bcarrillo1051/Atinverter/README.md

# Atinverter
Open Source DC to AC Inverter Documentation: https://bcarrillo1051.github.io/Atinverter/
