bcarrillo1051/Atinverter/sims/Boost Converter/ExportFiles/README.txt

## WEBENCH Design 4
Created at Sat Feb 22 22:12:48 CST 2025
**********************************************************
*******************  SIMULATION Instructions  ************
**********************************************************

This TINA Schematic can be opened in TINA-TI and simulated using TINA-TI. 

TINA-TI provides all the conventional DC, transient and frequency domain 
analysis of SPICE and much more. TINA has extensive post-processing capability 
that allows you to format results the way you want them. Virtual instruments 
allow you to select input waveforms and probe circuit nodes voltages and waveforms. 
TINA's schematic capture is truly intuitive - a real "quickstart."

TINA-TI installation requires approximately 500MB. Installation is straight-forward
 and it can be uninstalled easily, if you wish. We bet that you won't.

TINA is a product of DesignSoft exclusively for Texas Instruments. 
This complimentary version is fully functional but does not support some other 
features available with the full version of TINA.

For a complete list of available TINA-TI models, see: SpiceRack -- A Complete List

https://webench.ti.com/webench5/spicemodels/?DCMP=hpa_hpa_elabs&HQS=spicerack#search=tina

Download TINA-TI:
http://www.ti.com/tool/TINA-TI

Installation guide:
https://training.ti.com/tina-ti-video-training-series

More about WEBENCH simulation export to TINA-TI:
http://www.ti.com/design-tools/webench-power-design/tina-export.html
