bcarrillo1051/Atinverter/docs/hardware/atinverter_v2/inter_board_comms.md

---
title: Inter-Board Communication
layout: default
parent: Atinverter V2 Hardware
nav_order: 2
mathjax: true
---

# **I2C Inter-Board Communication Hardware**
---

- **Will be documented once I2C bus is verified**
