bcarrillo1051/Atinverter/docs/index.md

---
title: Home
layout: default

nav_order: 1
---

# **Atinverter Documentation**
### Explore the documentation to learn more about this open source power inverter!

<html>
<head>
  <style>
    .all_images {
      text-align: center; /* Center the entire section */
    }

    /* Style for each image and button container */
    .image_button_container {
      display: inline-block; /* Make each container inline */
      text-align: center; /* Center content within each container */
      margin: 21px; /* Add spacing between containers */
    }

    /* Style for images */
    .image_button_container img {
      width: 200px;
      height: 200px;
    }
  </style>
</head>
<body>
  <div class="all_images">
    <!-- Vision Image and Button -->
    <div class="image_button_container">
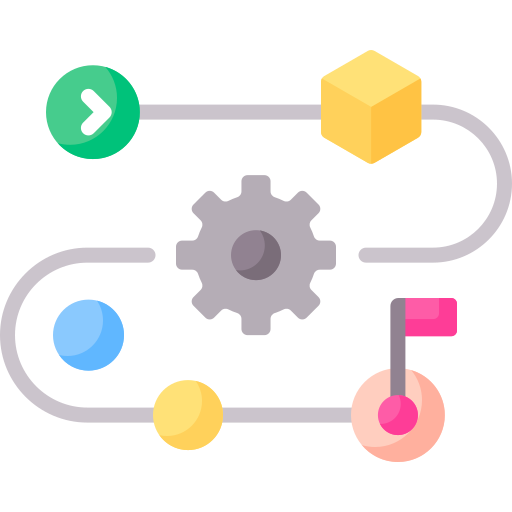
[picture p29: docs/images/vision.png]
Vision Icon
      
      <br>
      <span class="fs-6">
      <a href="vision" class="btn btn-purple">Vision</a>
      </span>
    </div>
    <!-- Hardware Image and Button -->
    <div class="image_button_container">
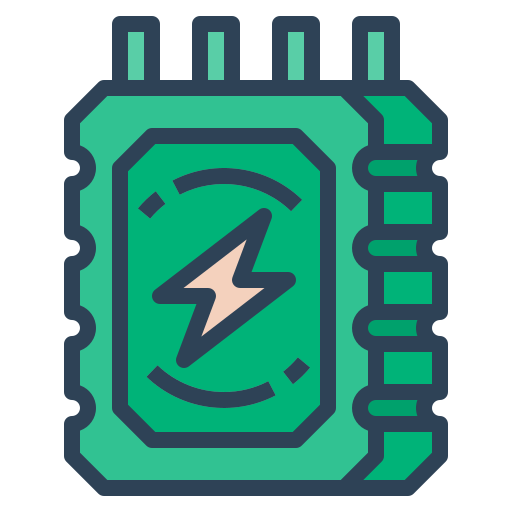
[picture p30: docs/images/hardware.png]
Hardware Icon
      
      <br>
      <span class="fs-6">
      <a href="hardware/hardware" class="btn btn-blue">Hardware</a>
      </span>
    </div>
    <!-- Software Image and Button -->
    <div class="image_button_container">
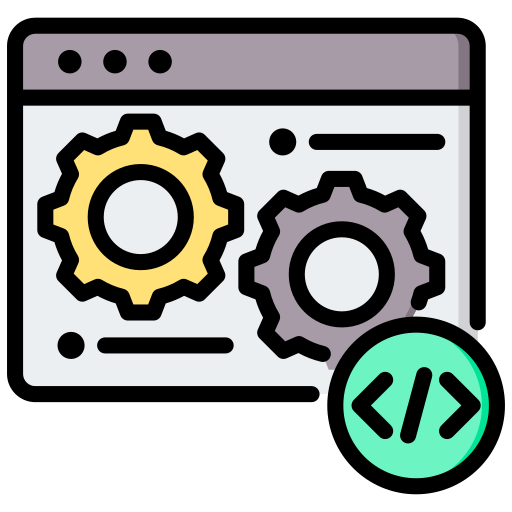
[picture p31: docs/images/software.png]
Software Icon
      
      <br>
      <span class="fs-6">
      <a href="software/software" class="btn btn-green">Software</a>
      </span>
    </div>
  </div>
</body>
</html>
