bcarrillo1051/Atinverter/docs/hardware/hardware.md

---
title: Hardware
layout: default
nav_order: 2
---

# **Hardware**
***

<html>
<head>
  <style>
    .all_images {
      text-align: center; /* Center the entire section */
    }

    /* Style for each image and button container */
    .image_button_container {
      display: inline-block; /* Make each container inline */
      text-align: center; /* Center content within each container */
      margin: 20px; /* Add spacing between containers */
    }

    /* Style for images */
    .image_button_container img {
      width: 220px;
      height: 220px;
    }
  </style>
</head>
<body>
  <div class="all_images">
    <!-- Atinverter V1 Image and Button -->
    <div class="image_button_container">
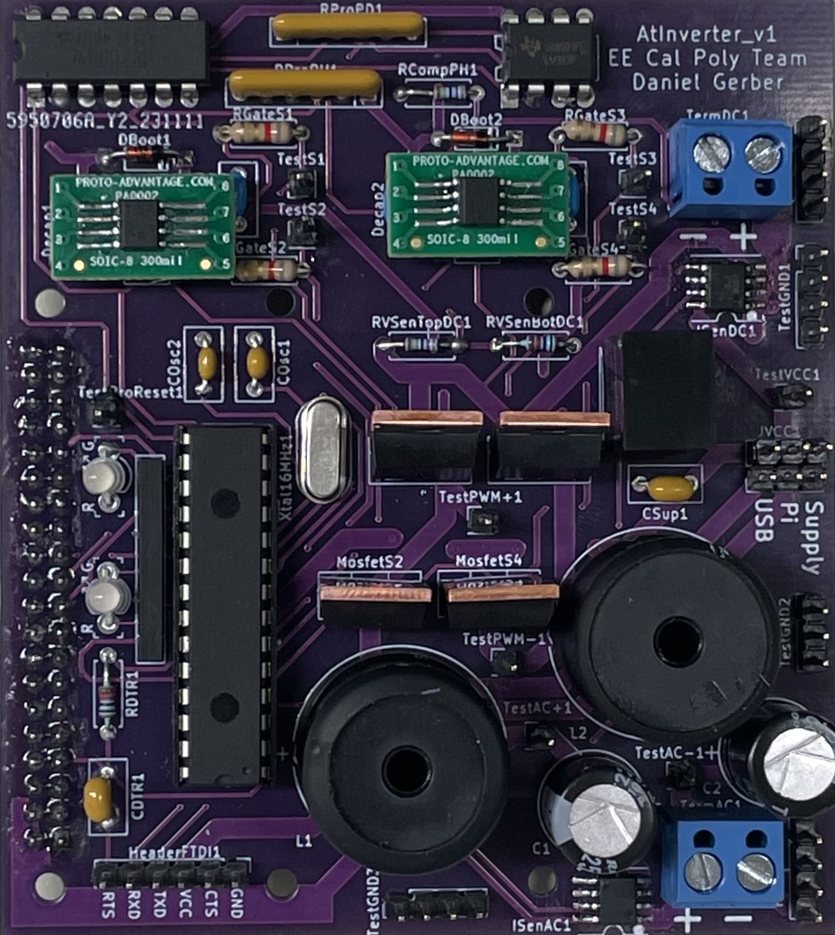
[picture p36: docs/images/a_v1_front_view.jpg]
Atinverter V1
      
      <br>
      <span class="fs-6">
      <a href="a_v1_hw" class="btn btn-purple">Atinverter V1</a>
      </span>
    </div>

    <!-- Atinverter V2 Image and Button -->
    <div class="image_button_container">
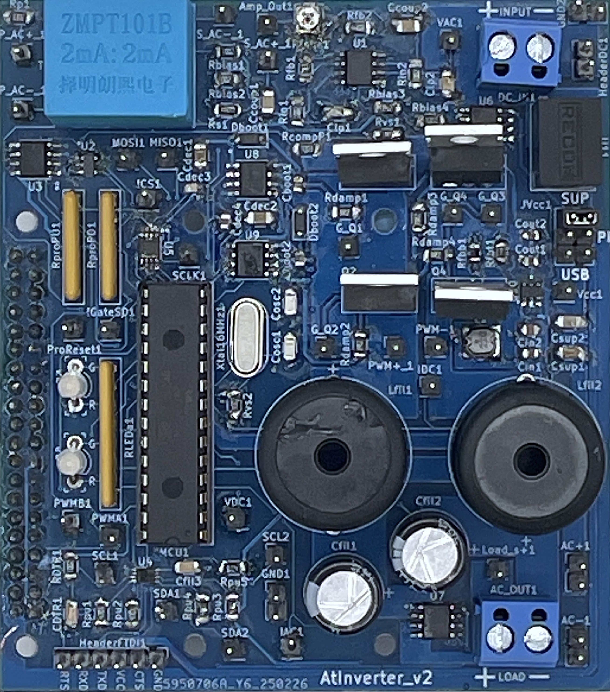
[picture p37: docs/images/AtinverterV2_top_view_raw.jpg]
Atinverter V2
      
      <br>
      <span class="fs-6">
      <a href="atinverter_v2/a_v2_hw" class="btn btn-green">Atinverter V2</a>
      </span>
    </div>
  </div>
</body>
</html>
