bcarrillo1051/Atinverter/docs/images/a_v1_sections.png

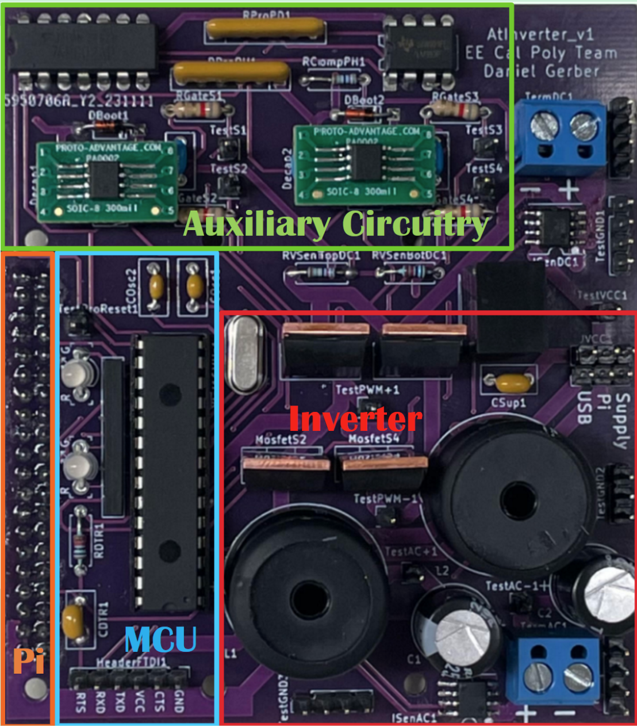
docs/images/a_v1_sections.png
