bcarrillo1051/Atinverter/docs/images/AC_voltage_sensing_circuit.png

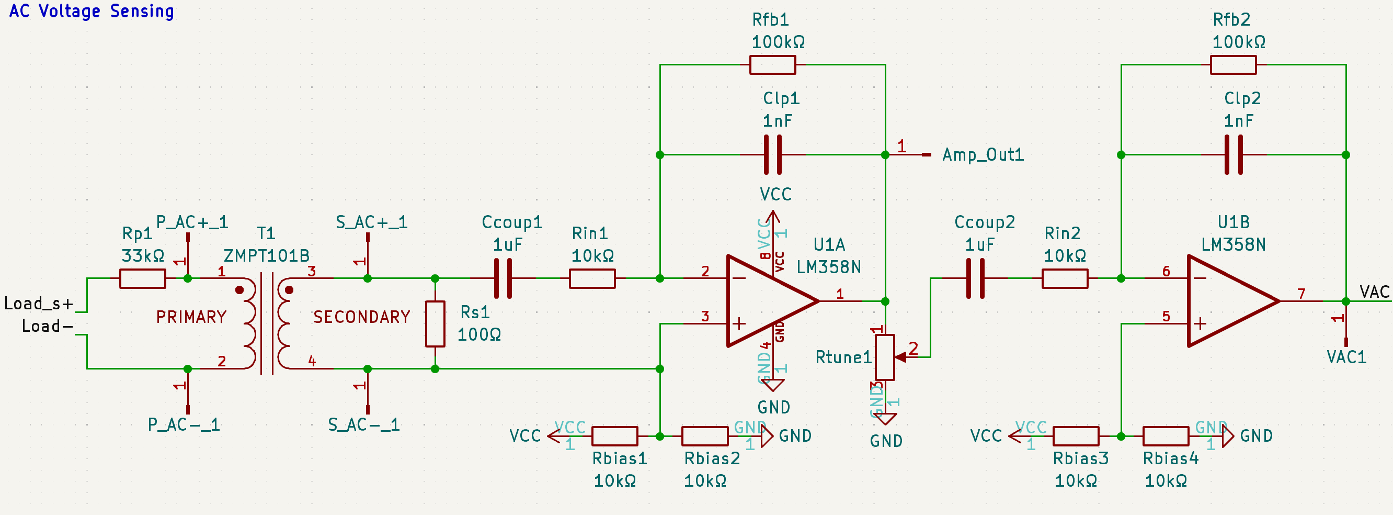
docs/images/AC_voltage_sensing_circuit.png
