bcarrillo1051/Atinverter/docs/images/AC_voltage_sensing_network_simulation_plot.png

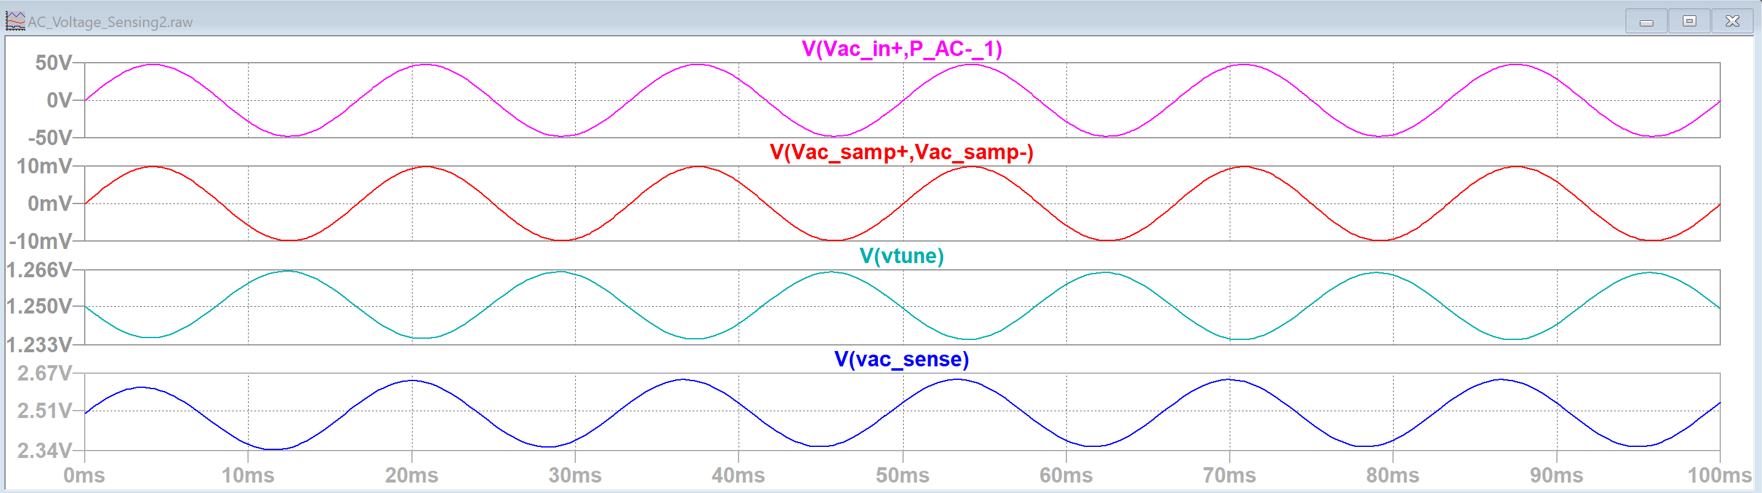
docs/images/AC_voltage_sensing_network_simulation_plot.png
