bcarrillo1051/Atinverter/docs/images/ADC_sampling_rate_sinusoid.png

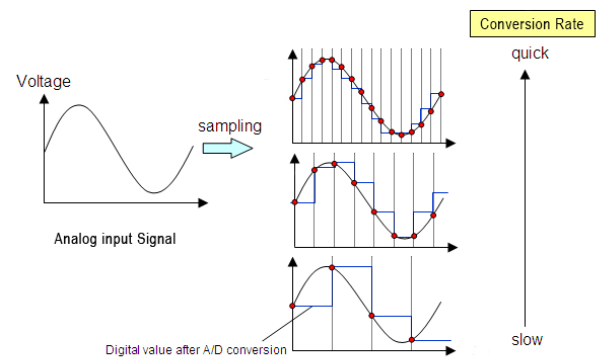
docs/images/ADC_sampling_rate_sinusoid.png
