bcarrillo1051/Atinverter/docs/images/atinverter_library_features.png

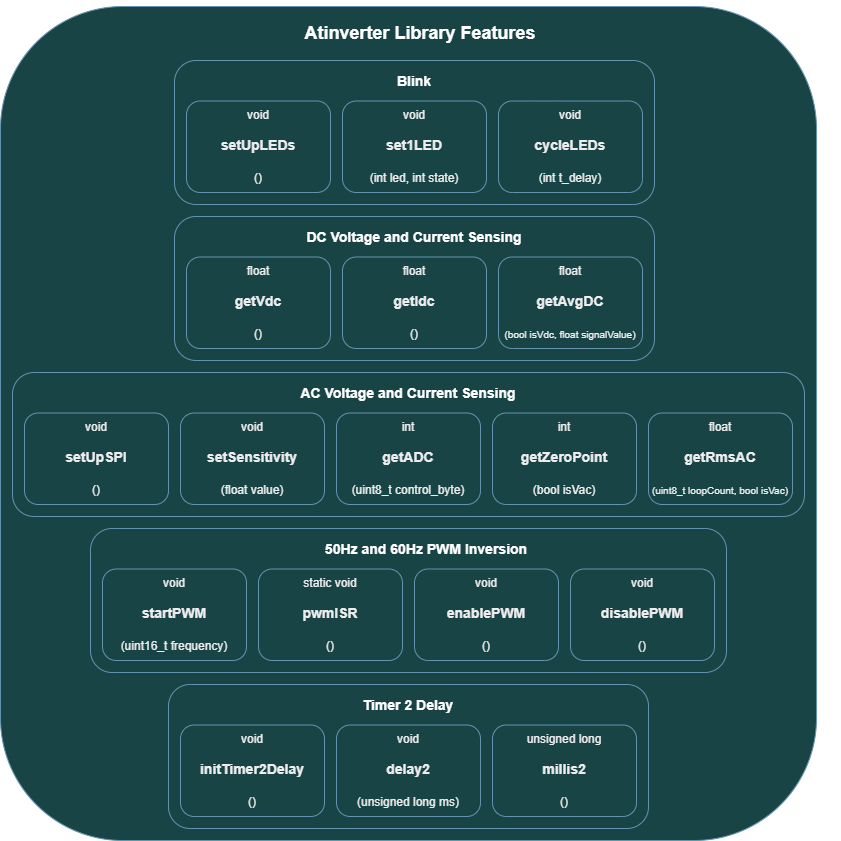
docs/images/atinverter_library_features.png
