bcarrillo1051/Atinverter/docs/images/atinverter_library_high_level.png

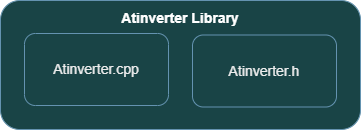
docs/images/atinverter_library_high_level.png
