bcarrillo1051/Atinverter/docs/images/atinverter_V2_software_modules_and_files.png

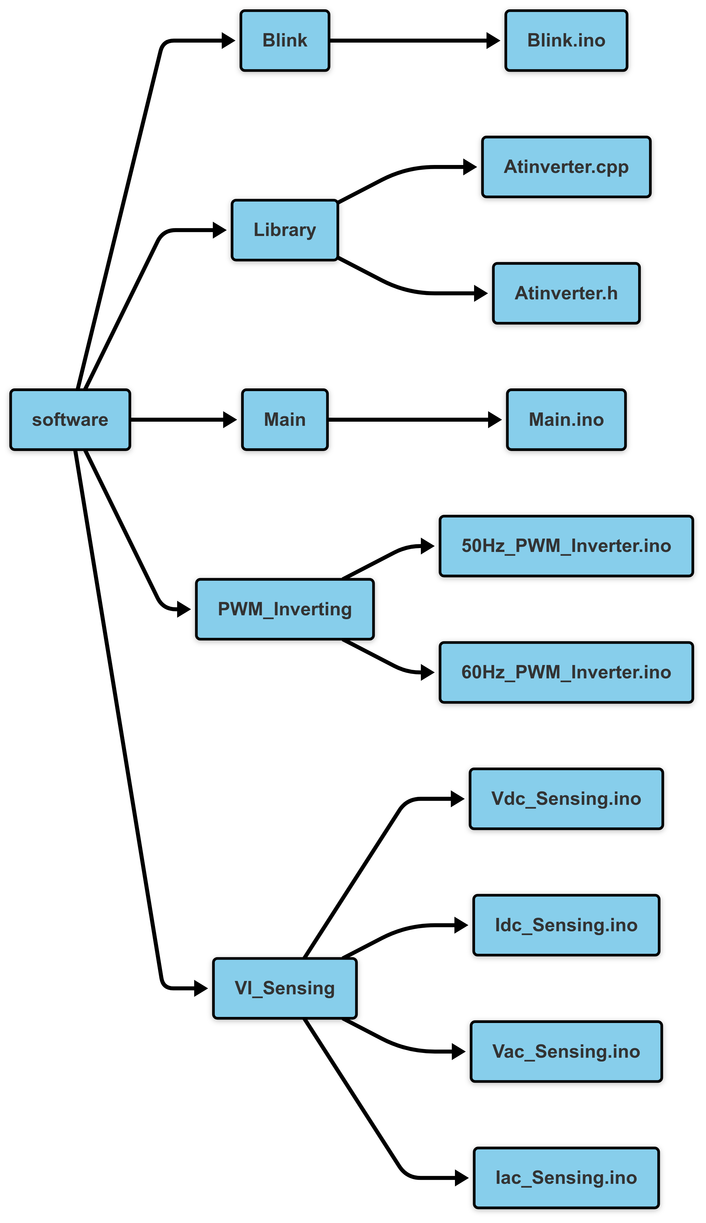
docs/images/atinverter_V2_software_modules_and_files.png
