bcarrillo1051/Atinverter/docs/images/AtinverterV2_top_view_labels.jpg

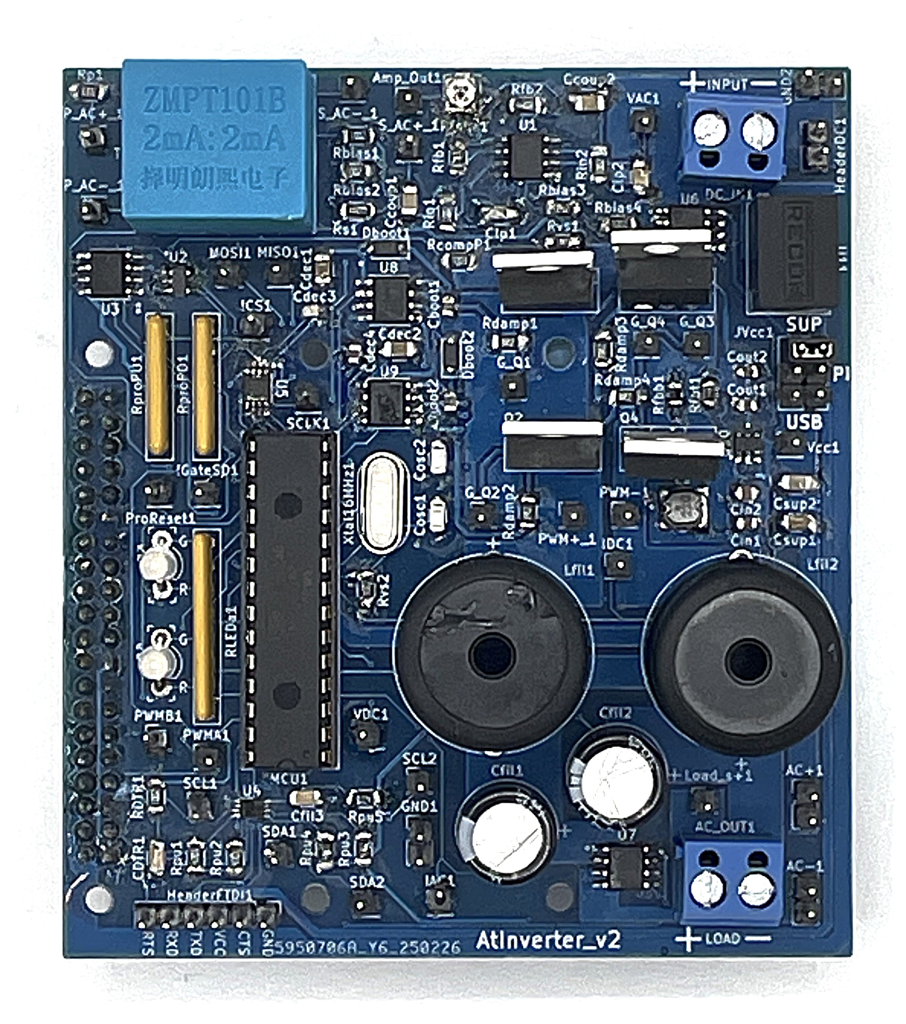
docs/images/AtinverterV2_top_view_labels.jpg
