bcarrillo1051/Atinverter/docs/images/boost_converter_duty_cycle_chart.png

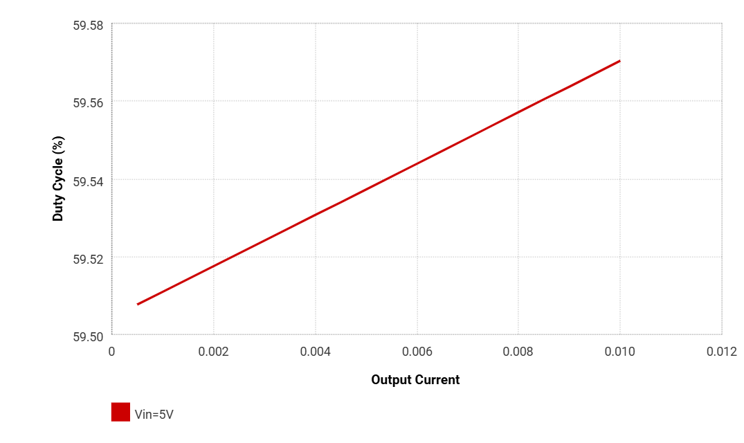
docs/images/boost_converter_duty_cycle_chart.png
