bcarrillo1051/Atinverter/docs/images/hall_effect_1.png

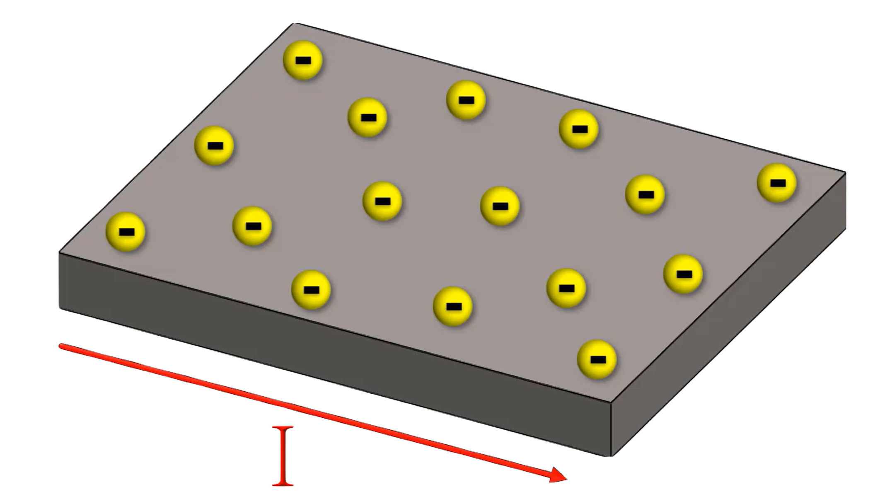
docs/images/hall_effect_1.png
