bcarrillo1051/Atinverter/docs/images/hall_effect_2.png

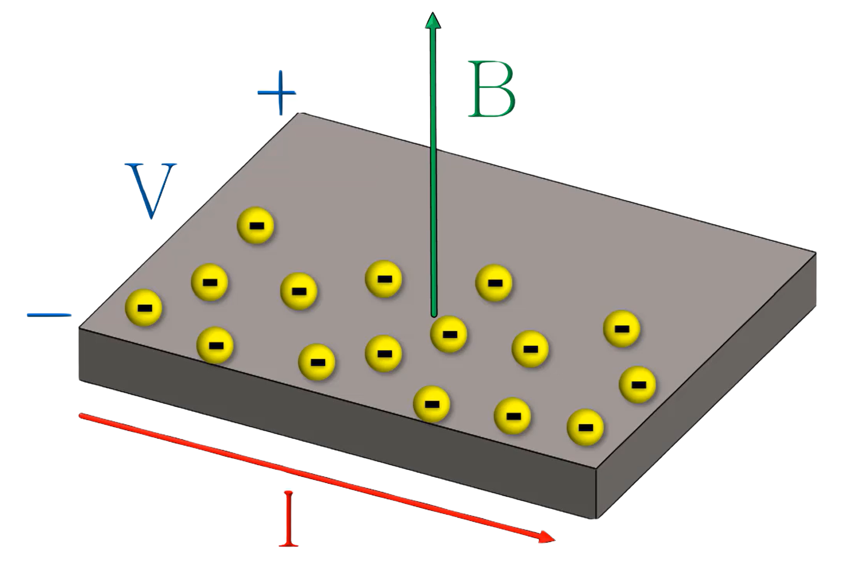
docs/images/hall_effect_2.png
