bcarrillo1051/Atinverter/docs/images/hall_effect_white_background.png

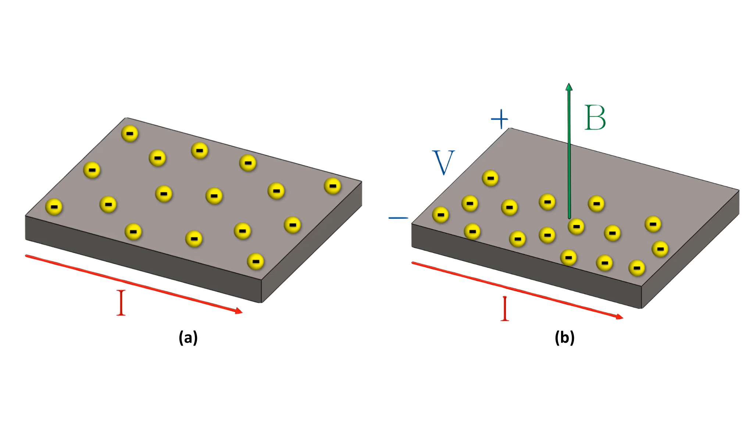
docs/images/hall_effect_white_background.png
