bcarrillo1051/Atinverter/docs/images/OVRP_circuit_white.png

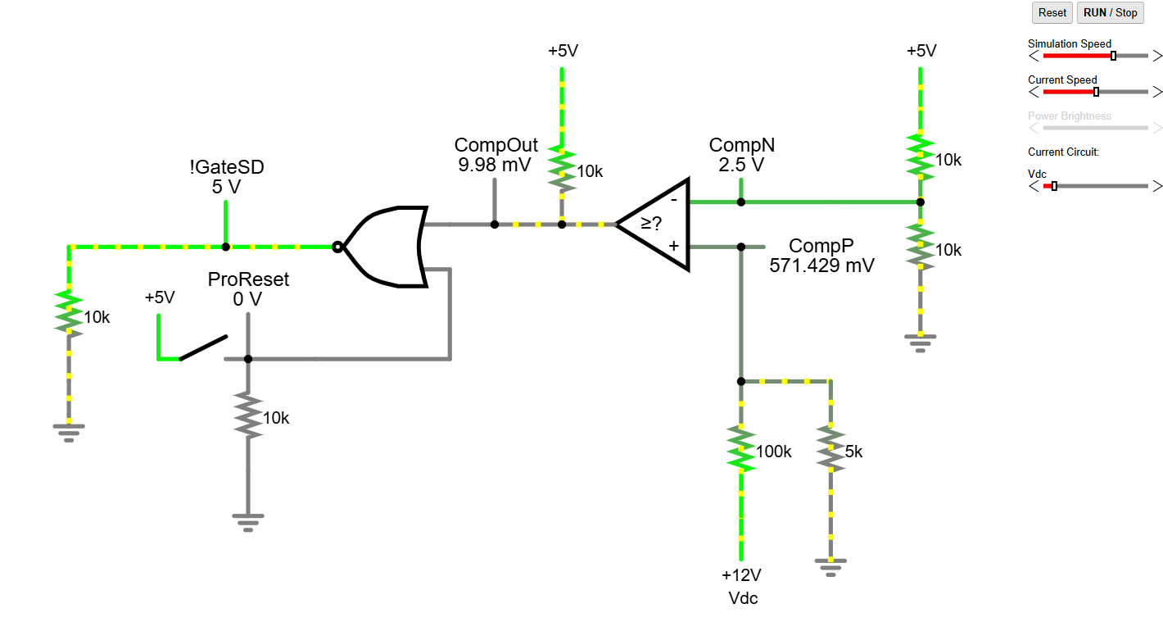
docs/images/OVRP_circuit_white.png
