bcarrillo1051/Atinverter/docs/images/software_block_diagram.png

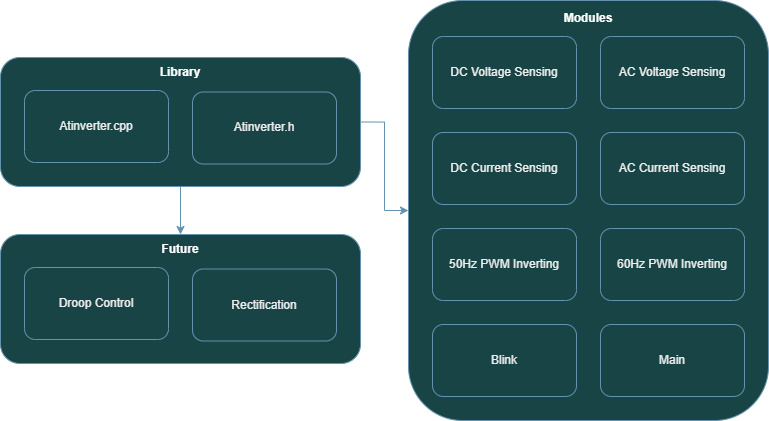
docs/images/software_block_diagram.png
