bcarrillo1051/Atinverter/docs/images/software_high_level.png

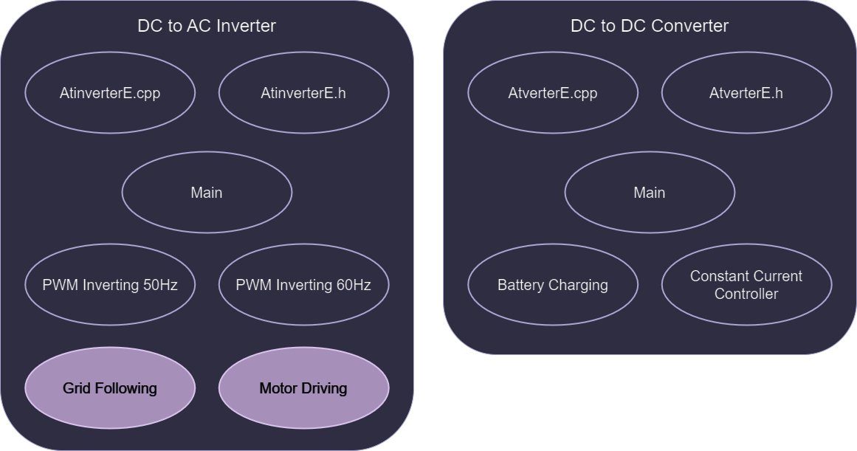
docs/images/software_high_level.png
