bcarrillo1051/Atinverter/docs/images/software_inverter.png

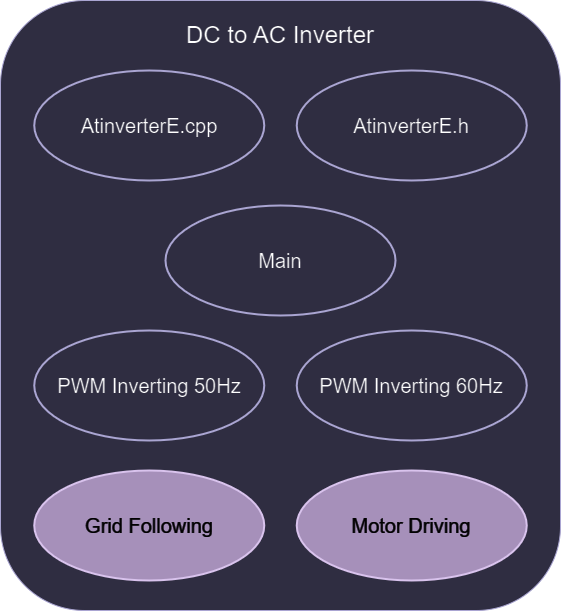
docs/images/software_inverter.png
