bcarrillo1051/Atinverter/sims/Boost Converter/12V_BOOST_CONVERTER.png

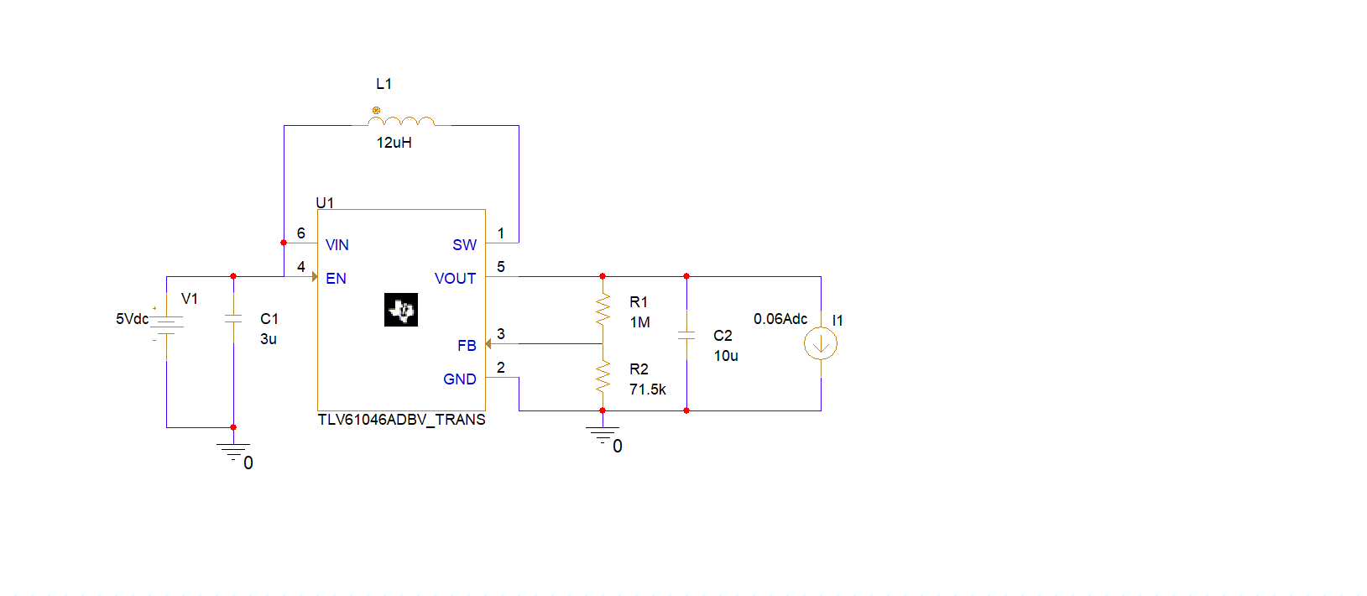
sims/Boost Converter/12V_BOOST_CONVERTER.png
