bcarrillo1051/Atinverter/docs/images/experimentation/ac_current_sensing/24.5ohms_reading.png

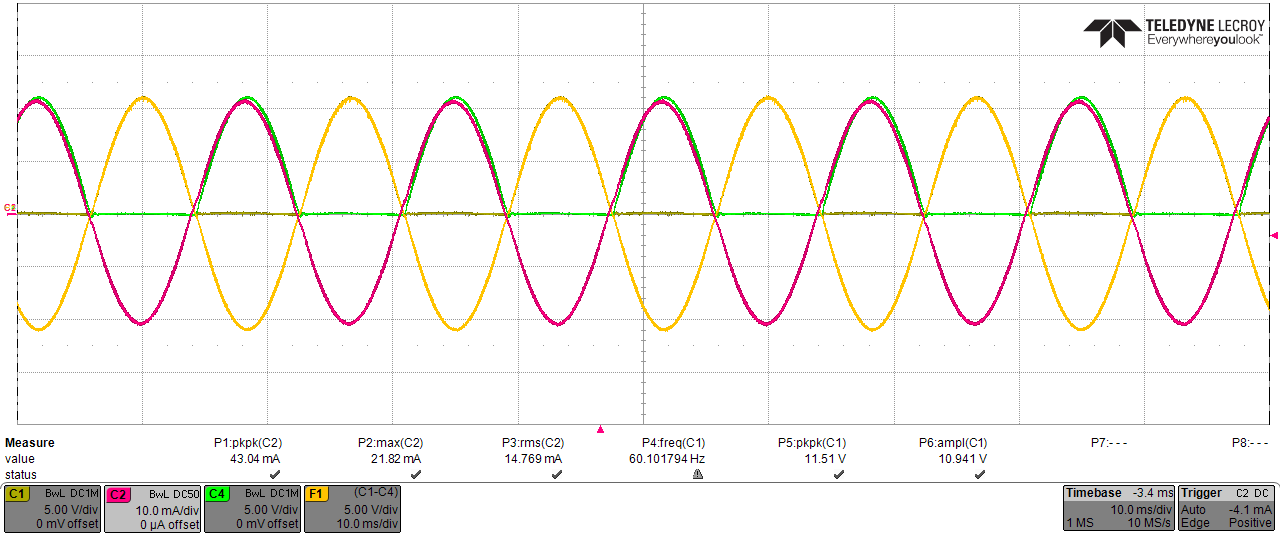
docs/images/experimentation/ac_current_sensing/24.5ohms_reading.png
