bcarrillo1051/Atinverter/docs/images/experimentation/ac_current_sensing/36. ohm_reading.png

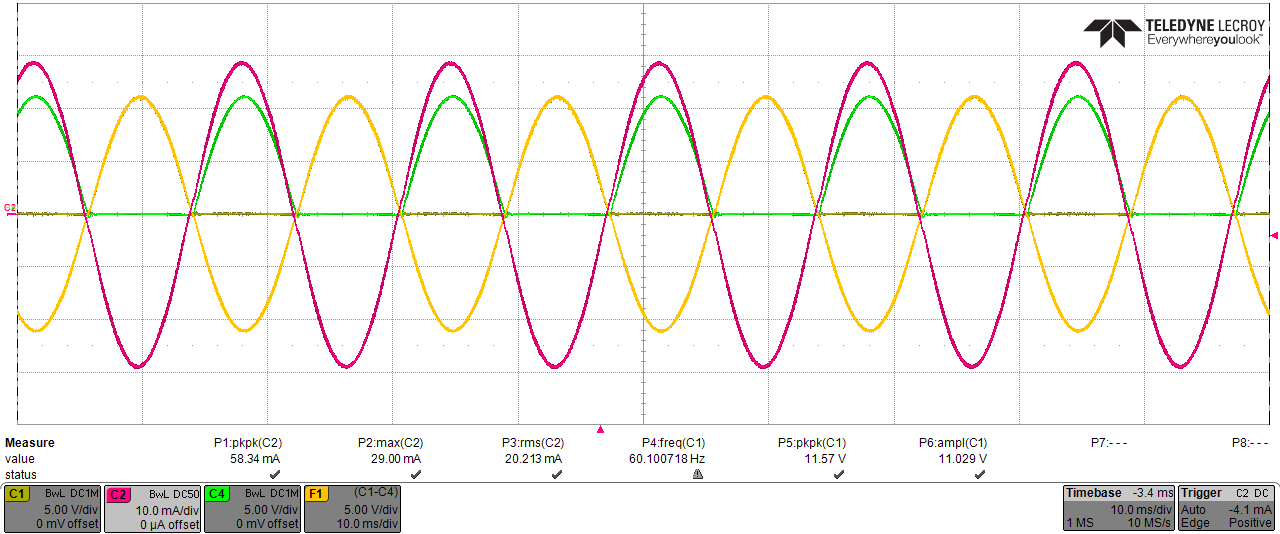
docs/images/experimentation/ac_current_sensing/36. ohm_reading.png
