bcarrillo1051/Atinverter/docs/images/experimentation/ac_current_sensing/69.6ohms_reading1.png

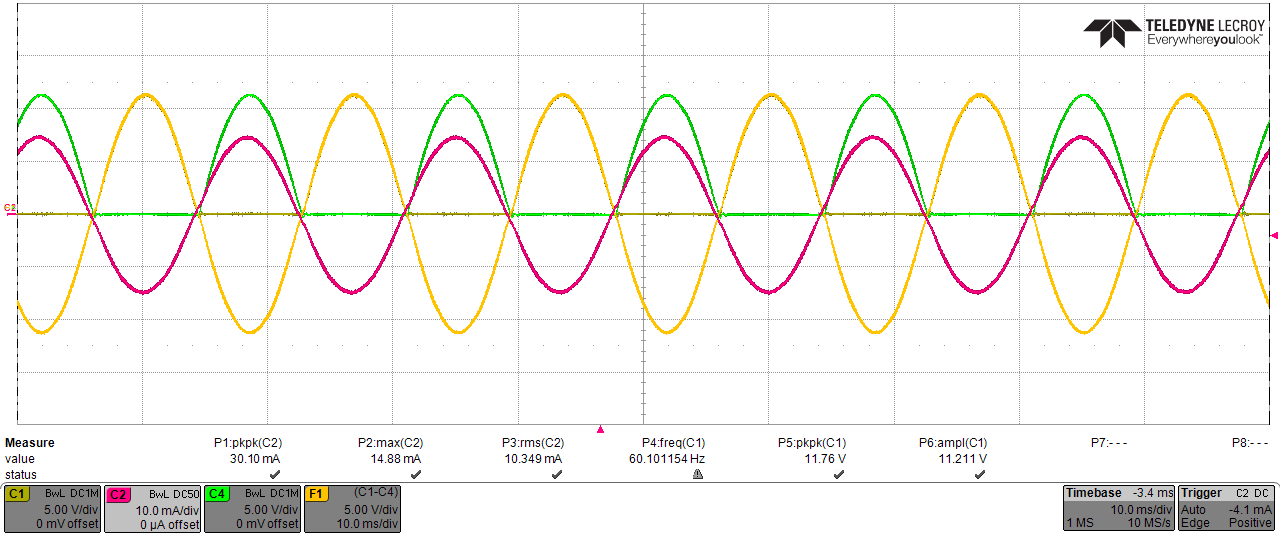
docs/images/experimentation/ac_current_sensing/69.6ohms_reading1.png
