bcarrillo1051/Atinverter/docs/images/experimentation/ac_current_sensing/4990 ohms load current reading.png

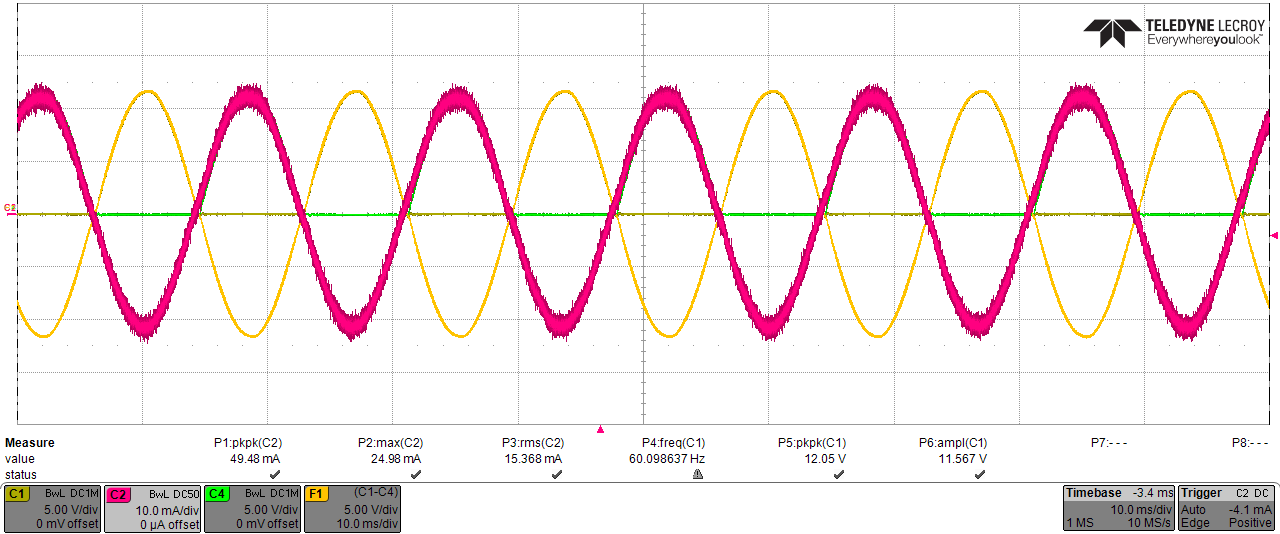
docs/images/experimentation/ac_current_sensing/4990 ohms load current reading.png
