bcarrillo1051/Atinverter/docs/images/experimentation/ac_current_sensing/current and voltqy.png

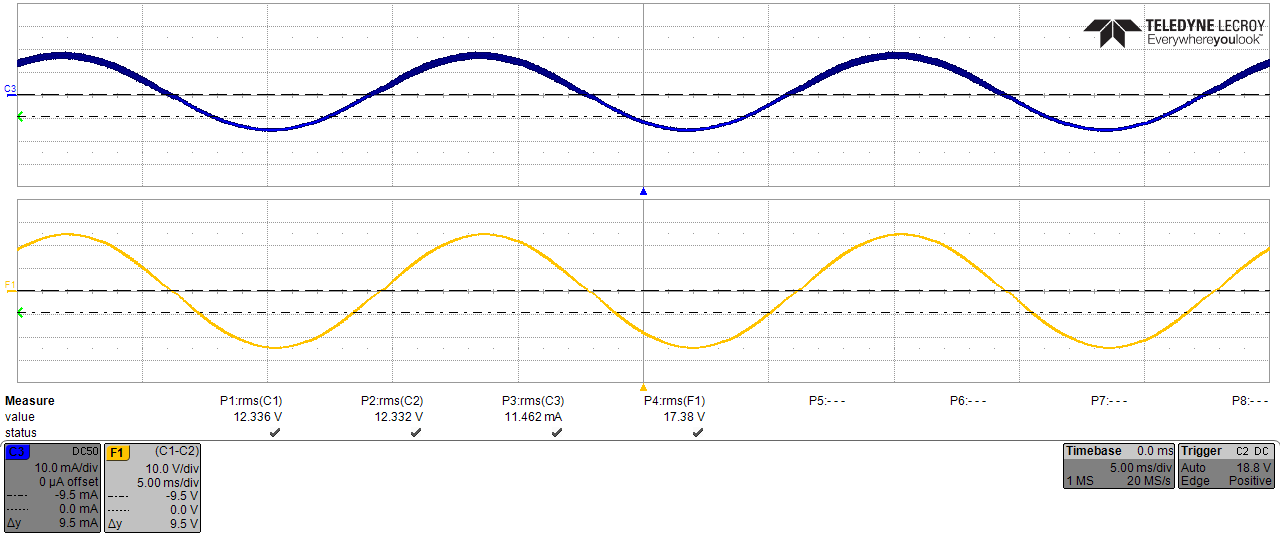
docs/images/experimentation/ac_current_sensing/current and voltqy.png
