bcarrillo1051/Atinverter/docs/images/experimentation/ac_current_sensing/distortion1.png

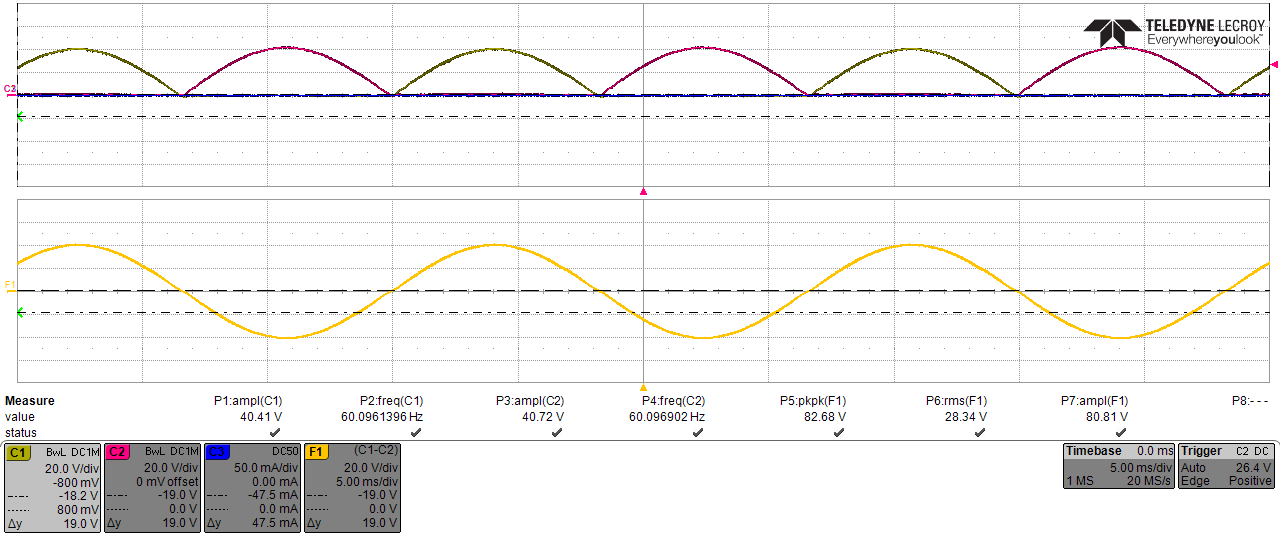
docs/images/experimentation/ac_current_sensing/distortion1.png
