bcarrillo1051/Atinverter/docs/images/experimentation/ac_current_sensing/distortion.png

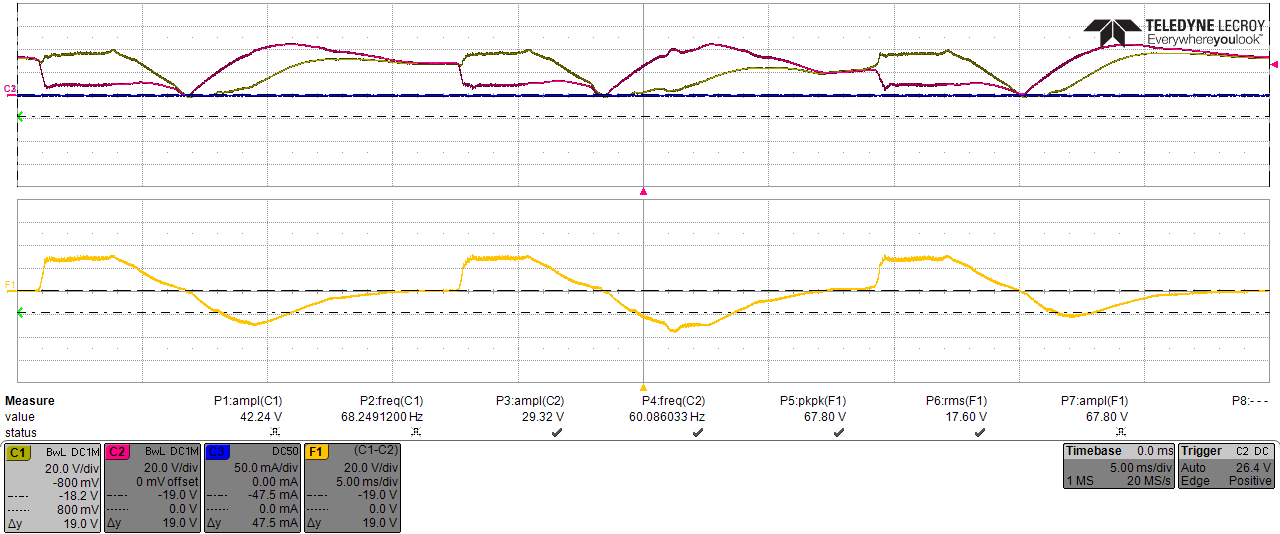
docs/images/experimentation/ac_current_sensing/distortion.png
