bcarrillo1051/Atinverter/docs/images/experimentation/ac_voltage_sensing/12Vin_Amp_Out1_60Hz.png

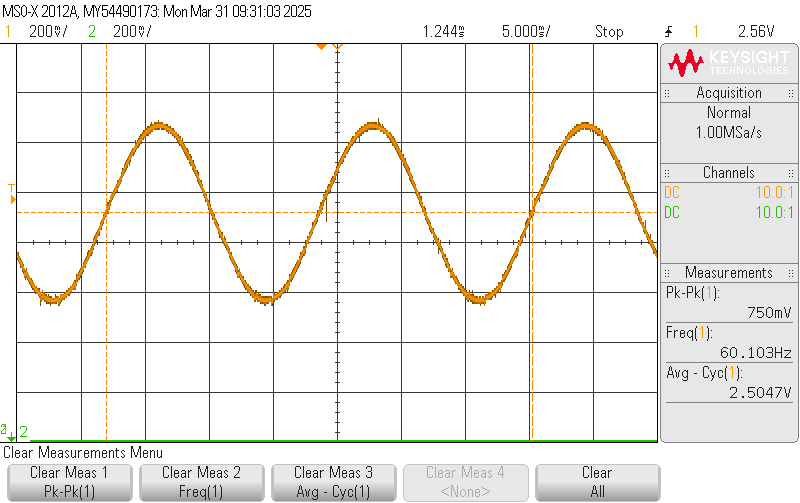
docs/images/experimentation/ac_voltage_sensing/12Vin_Amp_Out1_60Hz.png
