bcarrillo1051/Atinverter/docs/images/experimentation/ac_voltage_sensing/12Vin_P_AC+_1_P_AC-_1_60Hz.png

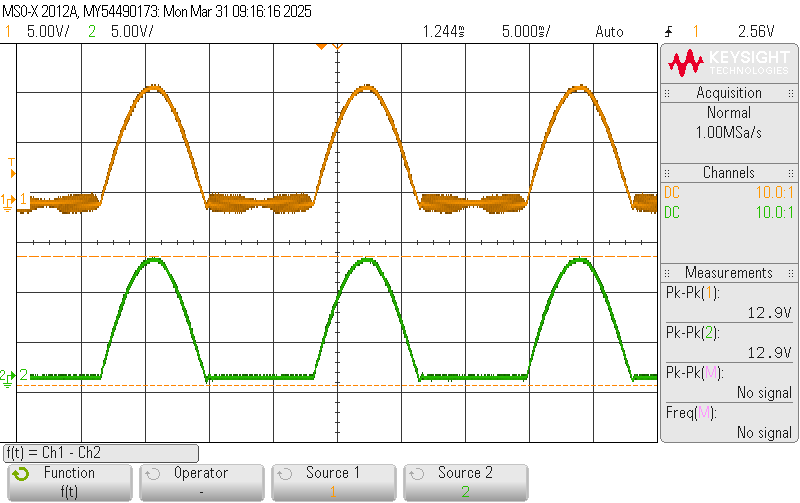
docs/images/experimentation/ac_voltage_sensing/12Vin_P_AC+_1_P_AC-_1_60Hz.png
