bcarrillo1051/Atinverter/docs/images/experimentation/ac_voltage_sensing/12Vin_Vac_Readings.png

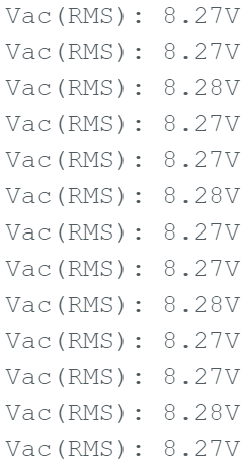
docs/images/experimentation/ac_voltage_sensing/12Vin_Vac_Readings.png
