bcarrillo1051/Atinverter/docs/images/experimentation/dc_current_sensing/Idc_reading_42.3kohm_load.png

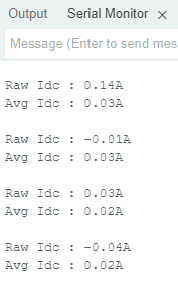
docs/images/experimentation/dc_current_sensing/Idc_reading_42.3kohm_load.png
