bcarrillo1051/Atinverter/docs/images/experimentation/power_supplies/12V_Boost_prev.png

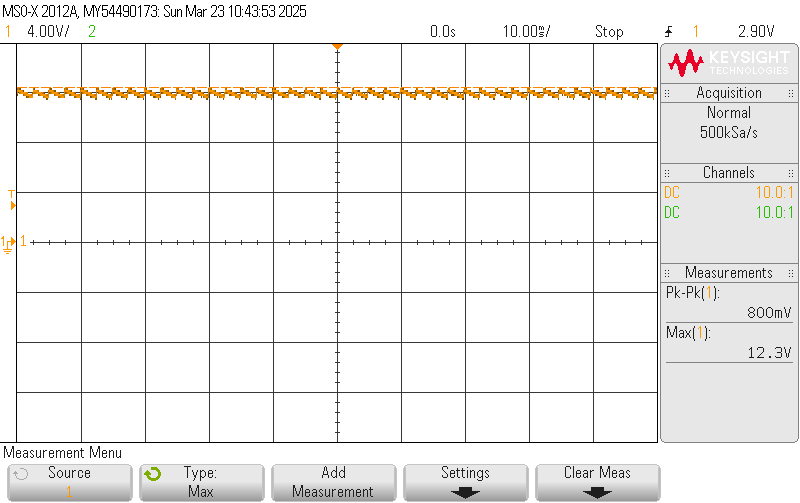
docs/images/experimentation/power_supplies/12V_Boost_prev.png
