bcarrillo1051/Atinverter/docs/images/experimentation/pwm_inversion/PWMB_low_duty_cycle.png

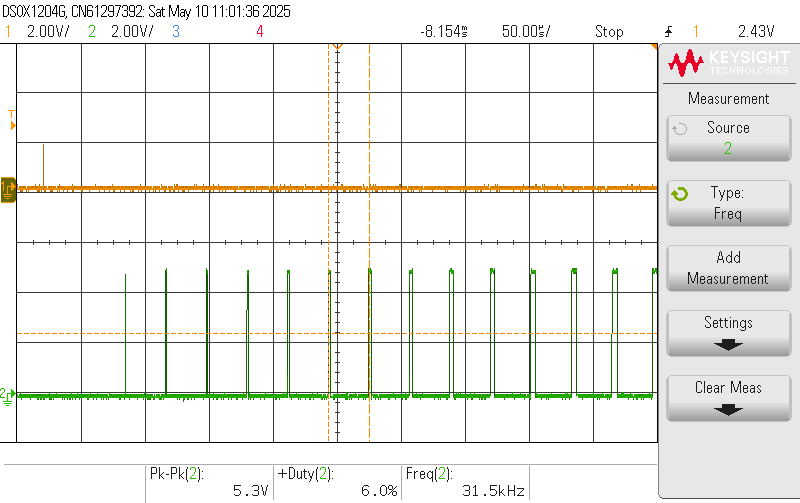
docs/images/experimentation/pwm_inversion/PWMB_low_duty_cycle.png
