bcarrillo1051/Atinverter/docs/images/AC_voltage_sensing_network_simulation.pdf

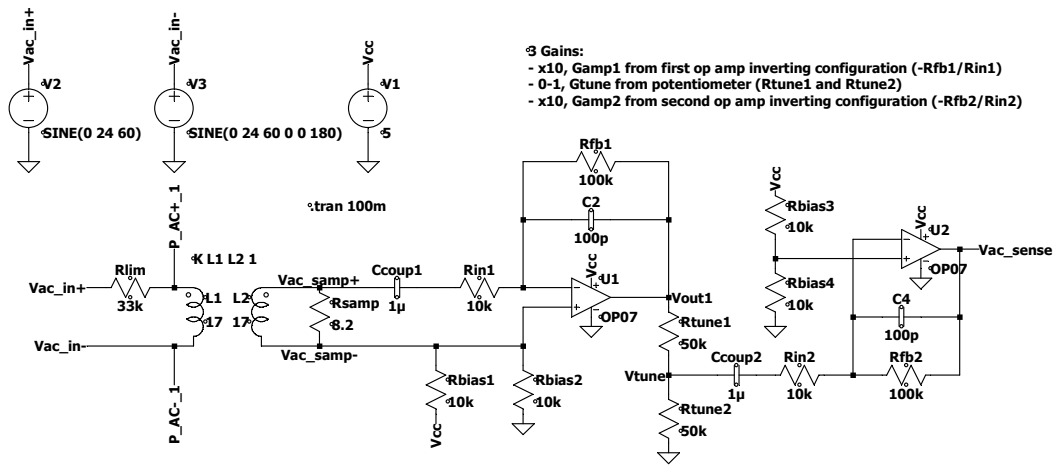
[picture p98: page 1]
Rlim; Rsamp; Ccoup1; Rin1; Rbias1 10k; Rbias2 10k; Rfb1; Rtune2 50k; Ccoup2; Rin2; 100p Rfb2; Rbias3 10k; Rbias4 10k; SINE(0 24 60); SINE(0 24 60 0 0 180); Rtune1; 50k Vcc; Vcc; Vcc Vcc; Vac_sense Vac_in+; Vac_in-; Vac_in+; Vtune; Vout1; Vac_samp+; Vac_samp-; .tran 100m

3 Gains:
- x10, Gamp1 from first op amp inverting configuration (-Rfb1/Rin1)
- 0-1, Gtune from potentiometer (Rtune1 and Rtune2)
- x10, Gamp2 from second op amp inverting configuration (-Rfb2/Rin2)
