bcarrillo1051/Atinverter/sims/AC Voltage Sensor/LTSpice/AC_Voltage_Sensing.asc

C2: cap; 100p
C4: cap; 100p
Ccoup1: cap; 1µ
Ccoup2: cap; 1µ
L1: ind2; 17
L2: ind2; 17
Rbias1: res; 10k
Rbias2: res; 10k
Rbias3: res; 10k
Rbias4: res; 10k
Rfb1: res; 100k
Rfb2: res; 100k
Rin1: res; 10k
Rin2: res; 10k
Rlim: res; 33k
Rsamp: res; 6.8
Rtune1: res; 1k
Rtune2: res; 99k
U1: OP07
U2: OP07
Vac_in: voltage; SINE(0 48 60 0 0)
Vcc: voltage; 5
Named nets: Vcc, 0, Vac_sense, Vac_in+, Vac_in-, P_AC+_1, P_AC-_1, Vtune, Vout1, Vac_samp+, Vac_samp-
K L1 L2 1
.tran 100m
3 Gains: 
- x10, Gamp1 from first op amp inverting configuration
- 0-1, Gtune from potentiometer (Rtune1 and Rtune2)
- x10, Gamp2 from second op amp inverting configuration
