bcarrillo1051/Atinverter/(list of files, drawings)

Other design files:
sims/Boost Converter/12V_BOOST_CONVERTER.DSN
sims/Boost Converter/12V_Boost_Converter.opj
