bcarrillo1051/Atinverter/KiCad/Projects/AtInverter_v2/AtInverter_v2.kicad_pcb

## KiCad design KiCad/Projects/AtInverter_v2/AtInverter_v2.kicad_pcb (2025-05-07)

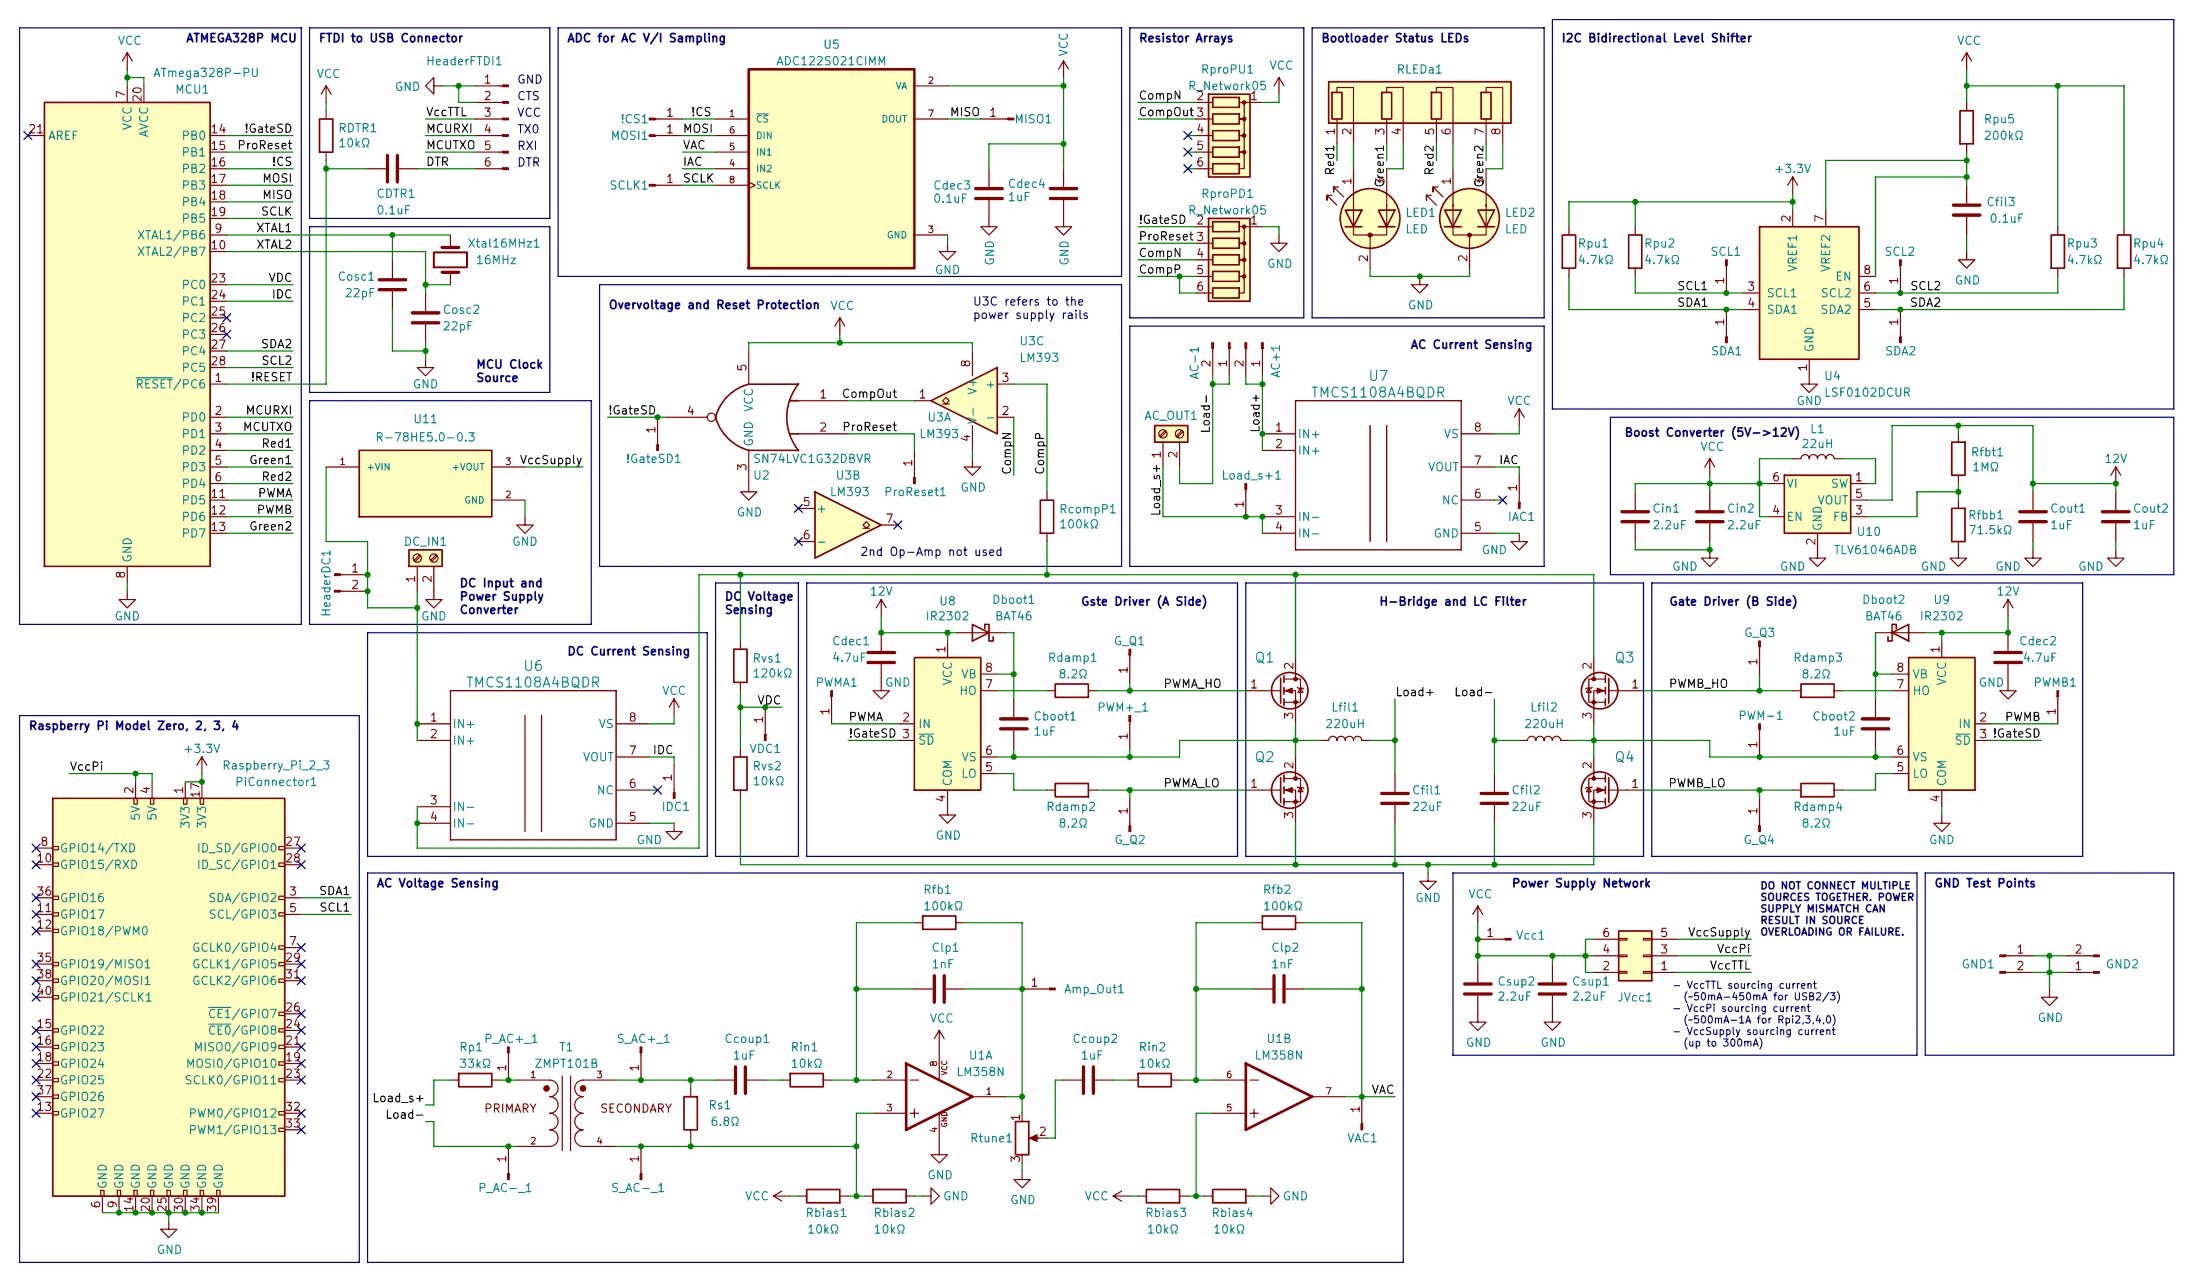
[picture p99: schematic AtInverter_v2.kicad_sch, AtInverter]

Parts:
!CS1: Conn_01x01_Male; PinHeader_1x01_P2.54mm_Vertical
!GateSD1: Conn_01x01_Male; PinHeader_1x01_P2.54mm_Vertical
AC+1: Conn_01x02_Pin; PinHeader_1x02_P2.54mm_Vertical
AC-1: Conn_01x02_Pin; PinHeader_1x02_P2.54mm_Vertical
AC_OUT1: Screw_Terminal_01x02; Term_Block_1x2_P5mm
Amp_Out1: Conn_01x01_Male; PinHeader_1x01_P2.54mm_Vertical
CDTR1: 0.1uF; C_1206_3216Metric
Cboot1, Cboot2: 1uF; C_0805_2012Metric
Ccoup1, Ccoup2: 1uF; C_1206_3216Metric
Cdec1, Cdec2: 4.7uF; C_1206_3216Metric
Cdec3: 0.1uF; C_0805_2012Metric
Cdec4: 1uF; C_0805_2012Metric
Cfil1, Cfil2: 22uF; CAP_BX_10x16_RUB
Cfil3: 0.1uF; C_1206_3216Metric
Cin1, Cin2: 2.2uF; C_0805_2012Metric
Clp1, Clp2: 1nF; C_1206_3216Metric
Cosc1, Cosc2: 22pF; C_1206_3216Metric
Cout1, Cout2: 1uF; C_0805_2012Metric
Csup1, Csup2: 2.2uF; C_1206_3216Metric
DC_IN1: Screw_Terminal_01x02; Term_Block_1x2_P5mm
Dboot1, Dboot2: BAT46; D_SOD-123
GND1, GND2: Conn_01x02_Pin; PinHeader_1x02_P2.54mm_Vertical
G_Q1, G_Q2, G_Q3, G_Q4: Conn_01x01_Male; PinHeader_1x01_P2.54mm_Vertical
HeaderDC1: Conn_01x02_Pin; PinHeader_1x02_P2.54mm_Vertical
HeaderFTDI1: Conn_01x06_Male; FTDI_USB_TTL_Header
IAC1: Conn_01x01_Male; PinHeader_1x01_P2.54mm_Vertical
IDC1: Conn_01x01_Male; PinHeader_1x01_P2.54mm_Vertical
JVcc1: Conn_02x03_Odd_Even; PinHeader_2x03_P2.54mm_Vertical
L1: 22uH; IND_BOURNS_SDR0403
LED1, LED2: LED; LED_3pin_P2.54mm
Lfil1, Lfil2: 220uH; AIRD-02_ABR
Load_s+1: Conn_01x01_Male; PinHeader_1x01_P2.54mm_Vertical
MCU1: ATmega328P-PU; DIP-28_W7.62mm_Socket
MISO1: Conn_01x01_Male; PinHeader_1x01_P2.54mm_Vertical
MOSI1: Conn_01x01_Male; PinHeader_1x01_P2.54mm_Vertical
PWM+_1: Conn_01x01_Male; PinHeader_1x01_P2.54mm_Vertical
PWM-1: Conn_01x01_Male; PinHeader_1x01_P2.54mm_Vertical
PWMA1: Conn_01x01_Male; PinHeader_1x01_P2.54mm_Vertical
PWMB1: Conn_01x01_Male; PinHeader_1x01_P2.54mm_Vertical
P_AC+_1: Conn_01x01_Male; PinHeader_1x01_P2.54mm_Vertical
P_AC-_1: Conn_01x01_Male; PinHeader_1x01_P2.54mm_Vertical
PiConnector1: Raspberry_Pi_2_3; Raspberry_Pi_Zero_and_Four
ProReset1: Conn_01x01_Male; PinHeader_1x01_P2.54mm_Vertical
Q1, Q2, Q3, Q4: IRFB4020PBF; TO-220-3_Vertical; MPN IRF540NPBF; Digi-Key_PN IRF540NPBF-ND
RDTR1: 10kΩ; R_1206_3216Metric
RLEDa1: R_Array; R_Array_SIP8
Rbias1, Rbias2, Rbias3, Rbias4: 10kΩ; R_1206_3216Metric
RcompP1: 100kΩ; R_1206_3216Metric
Rdamp1, Rdamp2, Rdamp3, Rdamp4: 8.2Ω; R_1206_3216Metric
Rfb1, Rfb2: 100kΩ; R_1206_3216Metric
Rfbb1: 71.5kΩ; R_0805_2012Metric
Rfbt1: 1MΩ; R_0805_2012Metric
Rin1, Rin2: 10kΩ; R_1206_3216Metric
Rp1: 33kΩ; R_1206_3216Metric
RproPD1: R_Network05; R_Array_SIP6
RproPU1: R_Network05; R_Array_SIP6
Rpu1, Rpu2, Rpu3, Rpu4: 4.7kΩ; R_1206_3216Metric
Rpu5: 200kΩ; R_1206_3216Metric
Rs1: 6.8Ω; R_1206_3216Metric
Rtune1: R_Potentiometer; TC33X-2-104E_BRN
Rvs1: 120kΩ; R_1206_3216Metric
Rvs2: 10kΩ; R_1206_3216Metric
SCL1, SCL2: Conn_01x01_Male; PinHeader_1x01_P2.54mm_Vertical
SCLK1: Conn_01x01_Male; PinHeader_1x01_P2.54mm_Vertical
SDA1, SDA2: Conn_01x01_Male; PinHeader_1x01_P2.54mm_Vertical
S_AC+_1: Conn_01x01_Male; PinHeader_1x01_P2.54mm_Vertical
S_AC-_1: Conn_01x01_Male; PinHeader_1x01_P2.54mm_Vertical
T1: ZMPT101B; XFMR_ZMPT101B; PARTREV NA
U1: LM358N; D8; PARTREV 1.0.3
U2: SN74LVC1G32DBVR; DBV5
U3: LM393; SO8_STM
U4: LSF0102DCUR; DCU0008A_L
U5: ADC122S021CIMM; MUA08A
U6, U7: TMCS1108A4BQDR; D0008A-IPC_A
U8, U9: IR2302; PG-DSO-8-910_INF
U10: TLV61046ADB; SOT-23-6
U11: R-78HE5.0-0.3; R-78HE-0.3_SIP3_11.5X8.5X12.5_RCP; PARTREV 0/2019
VAC1: Conn_01x01_Male; PinHeader_1x01_P2.54mm_Vertical
VDC1: Conn_01x01_Male; PinHeader_1x01_P2.54mm_Vertical
Vcc1: Conn_01x01_Male; PinHeader_1x01_P2.54mm_Vertical
Xtal16MHz1: 16MHz; Resonator-2Pin_W10.0mm_H5.0mm

Connections:
12V: Cdec1.1, Cdec2.1, Cout1.1, Cout2.1, Dboot1.2 (A), Dboot2.2 (A), Rfbt1.2, U8.1 (VCC), U9.1 (VCC), U10.5 (VOUT)
+3.3V: PiConnector1.1 (3V3), PiConnector1.17 (3V3), Rpu1.1, Rpu2.1, U4.2 (VREF1)
/!CS: !CS1.1, MCU1.16 (PB2), U5.1 (~CS)
/!GateSD: !GateSD1.1, MCU1.14 (PB0), RproPD1.2 (R1), U2.4, U8.3 (~SD), U9.3 (~SD)
/!RESET: CDTR1.2, MCU1.1 (~RESET/PC6), RDTR1.2
/CompN: RproPD1.4 (R3), RproPU1.2 (R1), U3.2 (-)
/CompOut: RproPU1.3 (R2), U2.1, U3.1
/CompP: RcompP1.1, RproPD1.5 (R4), RproPD1.6 (R5), U3.3 (+)
/DTR: CDTR1.1, HeaderFTDI1.6
/Green1: MCU1.5 (PD3), RLEDa1.3 (R2.1)
/Green2: MCU1.13 (PD7), RLEDa1.7 (R4.1)
/IAC: IAC1.1, U5.4 (IN2), U7.7 (VOUT)
/IDC: IDC1.1, MCU1.24 (PC1), U6.7 (VOUT)
/Load+: AC+1.1, AC+1.2, Cfil1.1, Lfil1.2, U7.1 (IN+), U7.2 (IN+)
/Load-: AC-1.1, AC-1.2, AC_OUT1.2, Cfil2.1, Lfil2.1, P_AC-_1.1, T1.2
/Load_s+: AC_OUT1.1, Load_s+1.1, Rp1.2, U7.3 (IN-), U7.4 (IN-)
/MCURXI: HeaderFTDI1.4, MCU1.2 (PD0)
/MCUTXO: HeaderFTDI1.5, MCU1.3 (PD1)
/MISO: MCU1.18 (PB4), MISO1.1, U5.7 (DOUT)
/MOSI: MCU1.17 (PB3), MOSI1.1, U5.6 (DIN)
/PWMA: MCU1.11 (PD5), PWMA1.1, U8.2 (IN)
/PWMA_HO: G_Q1.1, Q1.1 (G), Rdamp1.2
/PWMA_LO: G_Q2.1, Q2.1 (G), Rdamp2.2
/PWMB: MCU1.12 (PD6), PWMB1.1, U9.2 (IN)
/PWMB_HO: G_Q3.1, Q3.1 (G), Rdamp3.2
/PWMB_LO: G_Q4.1, Q4.1 (G), Rdamp4.2
/ProReset: MCU1.15 (PB1), ProReset1.1, RproPD1.3 (R2), U2.2
/Red1: MCU1.4 (PD2), RLEDa1.1 (R1.1)
/Red2: MCU1.6 (PD4), RLEDa1.5 (R3.1)
/SCL1: PiConnector1.5 (SCL/GPIO3), Rpu2.2, SCL1.1, U4.3 (SCL1)
/SCL2: MCU1.28 (PC5), Rpu3.2, SCL2.1, U4.6 (SCL2)
/SCLK: MCU1.19 (PB5), SCLK1.1, U5.8 (SCLK)
/SDA1: PiConnector1.3 (SDA/GPIO2), Rpu1.2, SDA1.1, U4.4 (SDA1)
/SDA2: MCU1.27 (PC4), Rpu4.2, SDA2.1, U4.5 (SDA2)
/VAC: Clp2.1, Rfb2.1, U1.7, U5.5 (IN1), VAC1.1
/VDC: MCU1.23 (PC0), Rvs1.2, Rvs2.1, VDC1.1
/VccPi: JVcc1.3, PiConnector1.2 (5V), PiConnector1.4 (5V)
/VccSupply: JVcc1.5, U11.3 (+VOUT)
/VccTTL: HeaderFTDI1.3, JVcc1.1
/XTAL1: Cosc1.2, MCU1.9 (XTAL1/PB6), Xtal16MHz1.2
/XTAL2: Cosc2.1, MCU1.10 (XTAL2/PB7), Xtal16MHz1.1
GND: Cdec1.2, Cdec2.2, Cdec3.2, Cdec4.2, Cfil1.2, Cfil2.2, Cfil3.1, Cin1.2, Cin2.2, Cosc1.1, Cosc2.2, Cout1.2, Cout2.2, Csup1.2, Csup2.2, DC_IN1.2, GND1.1, GND1.2, GND2.1, GND2.2, HeaderFTDI1.1, HeaderFTDI1.2, LED1.2 (K), LED2.2 (K), MCU1.8 (GND), MCU1.22 (GND), PiConnector1.6 (GND), PiConnector1.9 (GND), PiConnector1.14 (GND), PiConnector1.20 (GND), PiConnector1.25 (GND), PiConnector1.30 (GND), PiConnector1.34 (GND), PiConnector1.39 (GND), Q2.3 (S), Q4.3 (S), Rbias2.1, Rbias4.2, Rfbb1.1, RproPD1.1 (common), Rtune1.3, Rvs2.2, U1.4, U2.3 (GND), U3.4 (V-), U4.1 (GND), U5.3 (GND), U6.5 (GND), U7.5 (GND), U8.4 (COM), U9.4 (COM), U10.2 (GND), U11.2 (GND)
unnamed: Amp_Out1.1, Clp1.1, Rfb1.1, Rtune1.1, U1.1
unnamed: Ccoup1.1, Rin1.2
unnamed: Ccoup2.1, Rin2.2
unnamed: Ccoup2.2, Rtune1.2
unnamed: Clp1.2, Rfb1.2, Rin1.1, U1.2
unnamed: Clp2.2, Rfb2.2, Rin2.1, U1.6
unnamed: DC_IN1.1, HeaderDC1.1, HeaderDC1.2, U6.1 (IN+), U6.2 (IN+), U11.1 (+VIN)
unnamed: Cboot1.1, Dboot1.1 (K), U8.8 (VB)
unnamed: Cboot2.1, Dboot2.1 (K), U9.8 (VB)
unnamed: LED1.1 (A1), RLEDa1.2 (R1.2)
unnamed: LED1.3 (A2), RLEDa1.4 (R2.2)
unnamed: LED2.1 (A1), RLEDa1.6 (R3.2)
unnamed: LED2.3 (A2), RLEDa1.8 (R4.2)
unnamed: Cboot1.2, Lfil1.1, PWM+_1.1, Q1.3 (S), Q2.2 (D), U8.6 (VS)
unnamed: Cboot2.2, Lfil2.2, PWM-1.1, Q3.3 (S), Q4.2 (D), U9.6 (VS)
unnamed: P_AC+_1.1, Rp1.1, T1.1
unnamed: Q1.2 (D), Q3.2 (D), RcompP1.2, Rvs1.1, U6.3 (IN-), U6.4 (IN-)
unnamed: Rbias3.2, Rbias4.1, U1.5
unnamed: Ccoup1.2, Rs1.2, S_AC+_1.1, T1.3
unnamed: Rbias1.2, Rbias2.2, Rs1.1, S_AC-_1.1, T1.4, U1.3
unnamed: Cfil3.2, Rpu5.2, U4.7 (VREF2), U4.8 (EN)
unnamed: Rdamp1.1, U8.7 (HO)
unnamed: Rdamp2.1, U8.5 (LO)
unnamed: Rdamp3.1, U9.7 (HO)
unnamed: Rdamp4.1, U9.5 (LO)
unnamed: Rfbb1.2, Rfbt1.1, U10.3 (FB)
unnamed: L1.2, U10.1 (SW)
VCC: Cdec3.1, Cdec4.1, Cin1.1, Cin2.1, Csup1.1, Csup2.1, JVcc1.2, JVcc1.4, JVcc1.6, L1.1, MCU1.7 (VCC), MCU1.20 (AVCC), RDTR1.1, Rbias1.1, Rbias3.1, RproPU1.1 (common), Rpu3.1, Rpu4.1, Rpu5.1, U1.8, U2.5 (VCC), U3.8 (V+), U5.2 (VA), U6.8 (VS), U7.8 (VS), U10.4 (EN), U10.6 (VI), Vcc1.1

Notes on the sheet:
RXI
MCU Clock Source
ADC for AC V/I Sampling
AC Current Sensing
Overvoltage and Reset Protection
Power Supply Network
Boost Converter (5V->12V)
GND
ATMEGA328P MCU
Raspberry Pi Model Zero, 2, 3, 4
VCC
FTDI to USB Connector
DC Voltage Sensing
DO NOT CONNECT MULTIPLE SOURCES TOGETHER. POWER SUPPLY MISMATCH CAN RESULT IN SOURCE OVERLOADING OR FAILURE.
TX0
H-Bridge and LC Filter
AC Voltage Sensing
I2C Bidirectional Level Shifter
Gate Driver (B Side)
U3C refers to the power supply rails
DC Input and Power Supply Converter
- VccTTL sourcing current (~50mA-450mA for USB2/3) - VccPi sourcing current (~500mA-1A for Rpi2,3,4,0) - VccSupply sourcing current (up to 300mA)
DTR
Bootloader Status LEDs
CTS
2nd Op-Amp not used
Resistor Arrays
DC Current Sensing
GND Test Points
Gste Driver (A Side)

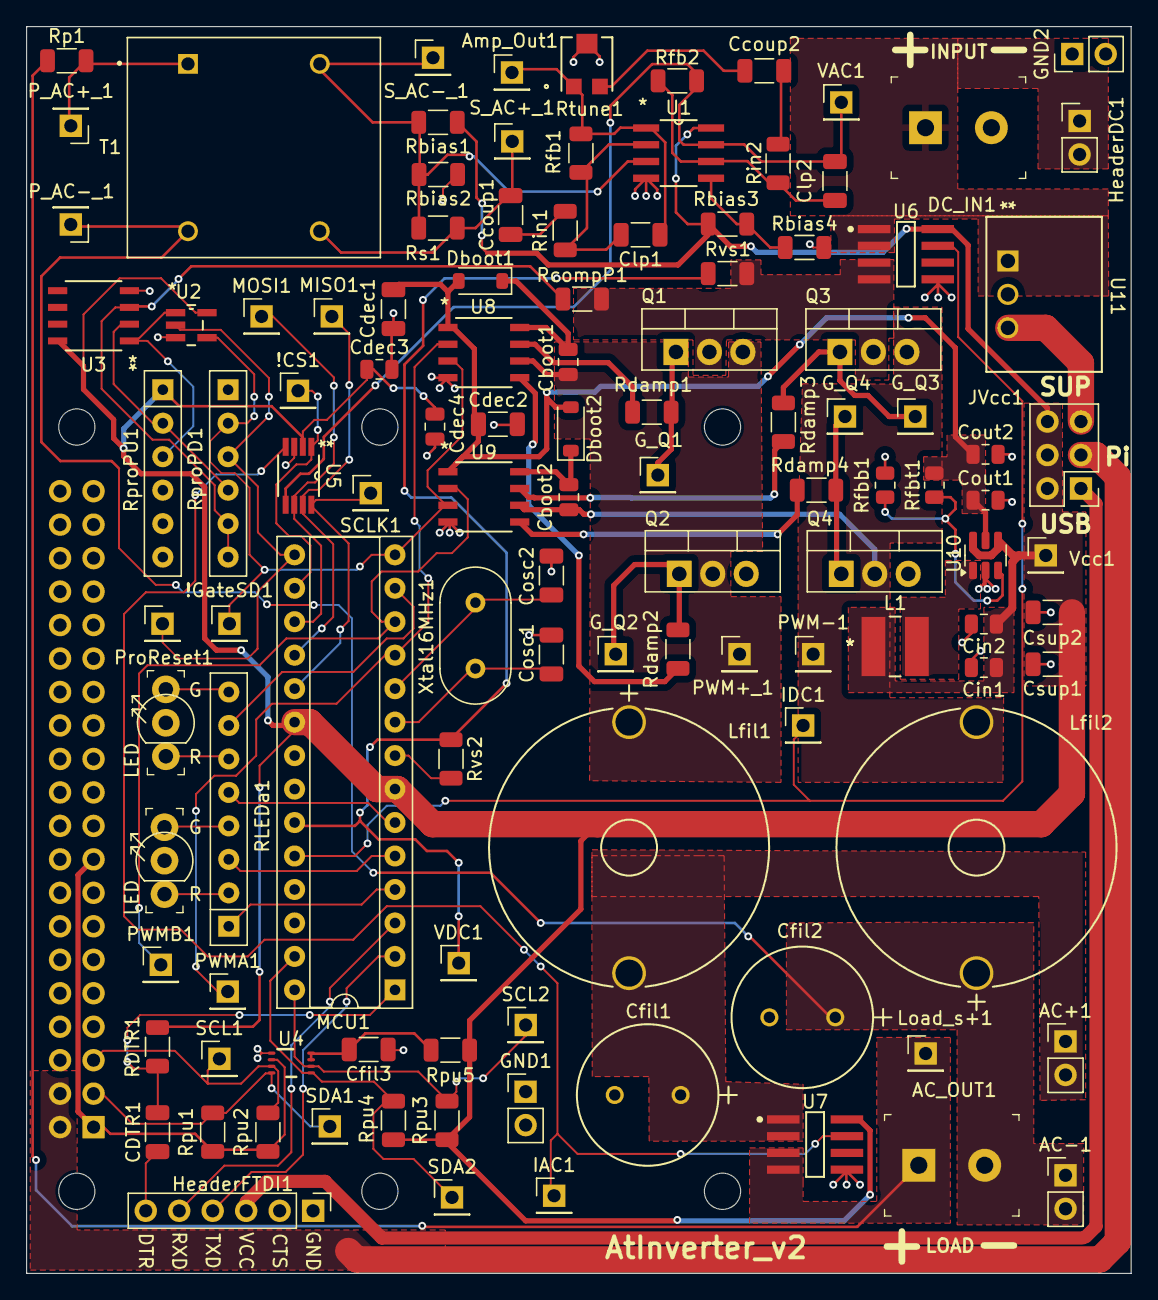
[picture p100: board AtInverter_v2.kicad_pcb from above]

Board: 2 copper layers, 83.8 x 94.6 mm, 115 parts (1 on the bottom side), 70 nets.
