bcarrillo1051/Atinverter/KiCad/Projects/AtInverter_v1/AtInverter_v1.kicad_pcb

## KiCad design KiCad/Projects/AtInverter_v1/AtInverter_v1.kicad_pcb (2025-03-24, an earlier design)

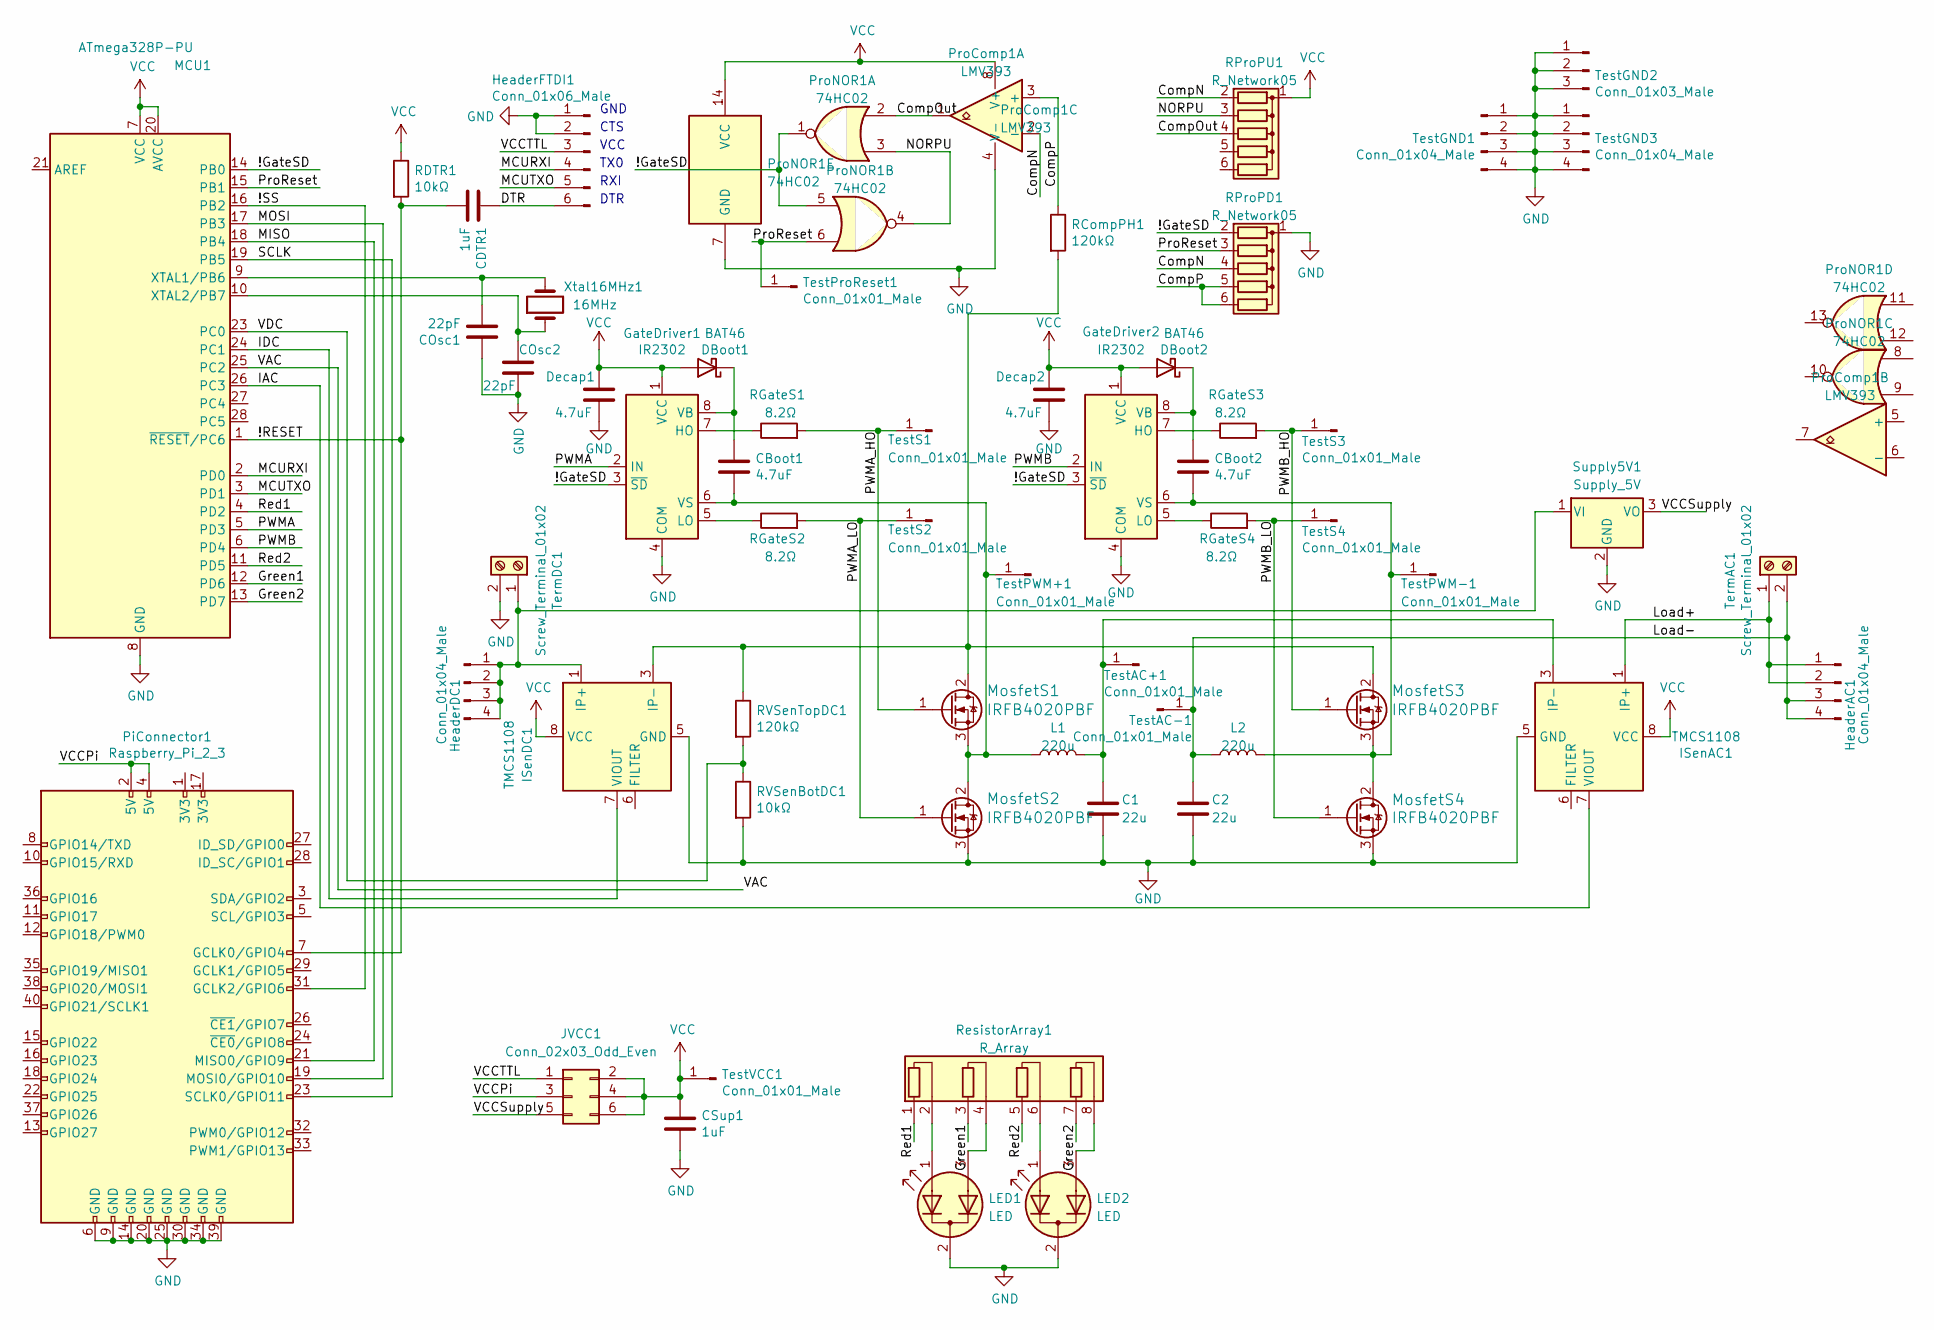
[picture p101: schematic AtInverter_v1.kicad_sch, AtInverter]

Parts:
C1, C2: 22u; CAP_BX_10x16_RUB
CBoot1, CBoot2: 4.7uF; C_Rect_L7.2mm_W3.5mm_P5.00mm_FKS2_FKP2_MKS2_MKP2
CDTR1: 1uF; C_Rect_L7.2mm_W3.5mm_P5.00mm_FKS2_FKP2_MKS2_MKP2
COsc1, COsc2: 22pF; C_Rect_L7.2mm_W3.5mm_P5.00mm_FKS2_FKP2_MKS2_MKP2
CSup1: 1uF; C_Rect_L7.2mm_W3.5mm_P5.00mm_FKS2_FKP2_MKS2_MKP2
DBoot1, DBoot2: BAT46; D_DO-35_SOD27_P7.62mm_Horizontal
Decap1, Decap2: 4.7uF; CAP_FG28_TDK
GateDriver1, GateDriver2: IR2302; DIP-8_W7.62mm_LongPads
HeaderAC1: Conn_01x04_Male; PinHeader_1x04_P2.54mm_Vertical
HeaderDC1: Conn_01x04_Male; PinHeader_1x04_P2.54mm_Vertical
HeaderFTDI1: Conn_01x06_Male; FTDI_USB_TTL_Header
ISenAC1: TMCS1108; SOIC-8_3.9x4.9mm_P1.27mm
ISenDC1: TMCS1108; SOIC-8_3.9x4.9mm_P1.27mm
JVCC1: Conn_02x03_Odd_Even; PinHeader_2x03_P2.54mm_Vertical
L1, L2: 220u; AIRD-02_ABR
LED1, LED2: LED; LED_3pin_P2.54mm
MCU1: ATmega328P-PU; DIP-28_W7.62mm
MosfetS1, MosfetS2, MosfetS3, MosfetS4: IRFB4020PBF; TO-220-3_Vertical; MPN IRF540NPBF; Digi-Key_PN IRF540NPBF-ND
PiConnector1: Raspberry_Pi_2_3; Raspberry_Pi_Zero_and_Four
ProComp1: LMV393; DIP-8_W7.62mm_LongPads
ProNOR1: 74HC02; DIP-14_W7.62mm_LongPads
RCompPH1: 120kΩ; R_Axial_DIN0207_L6.3mm_D2.5mm_P7.62mm_Horizontal
RDTR1: 10kΩ; R_Axial_DIN0207_L6.3mm_D2.5mm_P7.62mm_Horizontal
RGateS1, RGateS2, RGateS3, RGateS4: 8.2Ω; R_Axial_DIN0207_L6.3mm_D2.5mm_P7.62mm_Horizontal
RProPD1: R_Network05; R_Array_SIP6
RProPU1: R_Network05; R_Array_SIP6
RVSenBotDC1: 10kΩ; R_Axial_DIN0207_L6.3mm_D2.5mm_P7.62mm_Horizontal
RVSenTopDC1: 120kΩ; R_Axial_DIN0207_L6.3mm_D2.5mm_P7.62mm_Horizontal
ResistorArray1: R_Array; R_Array_SIP8
Supply5V1: Supply_5V; SupplyDC_48V-5V_TO-220-3_Vertical
TermAC1: Screw_Terminal_01x02; Term_Block_1x2_P5mm
TermDC1: Screw_Terminal_01x02; Term_Block_1x2_P5mm
TestAC+1: Conn_01x01_Male; PinHeader_1x01_P2.54mm_Vertical
TestAC-1: Conn_01x01_Male; PinHeader_1x01_P2.54mm_Vertical
TestGND1, TestGND3: Conn_01x04_Male; PinHeader_1x04_P2.54mm_Vertical
TestGND2: Conn_01x03_Male; PinHeader_1x03_P2.54mm_Vertical
TestPWM+1: Conn_01x01_Male; PinHeader_1x01_P2.54mm_Vertical
TestPWM-1: Conn_01x01_Male; PinHeader_1x01_P2.54mm_Vertical
TestProReset1: Conn_01x01_Male; PinHeader_1x01_P2.54mm_Vertical
TestS1, TestS2, TestS3, TestS4: Conn_01x01_Male; PinHeader_1x01_P2.54mm_Vertical
TestVCC1: Conn_01x01_Male; PinHeader_1x01_P2.54mm_Vertical
Xtal16MHz1: 16MHz; Resonator-2Pin_W10.0mm_H5.0mm

Connections:
/!GateSD: GateDriver1.3 (~SD), GateDriver2.3 (~SD), MCU1.14 (PB0), ProNOR1.1, ProNOR1.5, RProPD1.2 (R1)
/!RESET: CDTR1.2, MCU1.1 (~RESET/PC6), PiConnector1.7 (GCLK0/GPIO4), RDTR1.2
/!SS: MCU1.16 (PB2), PiConnector1.31 (GCLK2/GPIO6)
/CompN: ProComp1.2 (-), RProPD1.4 (R3), RProPU1.2 (R1)
/CompOut: ProComp1.1, ProNOR1.2, RProPU1.4 (R3)
/CompP: ProComp1.3 (+), RCompPH1.1, RProPD1.5 (R4), RProPD1.6 (R5); also elsewhere on the board
/DTR: CDTR1.1, HeaderFTDI1.6
/Green1: MCU1.12 (PD6), ResistorArray1.3 (R2.1)
/Green2: MCU1.13 (PD7), ResistorArray1.7 (R4.1)
/IAC: ISenAC1.7 (VIOUT), MCU1.26 (PC3)
/IDC: ISenDC1.7 (VIOUT), MCU1.24 (PC1)
/Load+: HeaderAC1.1, HeaderAC1.2, ISenAC1.1 (IP+), ISenAC1.2 (IP+), TermAC1.1
/Load-: C2.1, HeaderAC1.3, HeaderAC1.4, L2.1, TermAC1.2, TestAC-1.1
/MCURXI: HeaderFTDI1.4, MCU1.2 (PD0)
/MCUTXO: HeaderFTDI1.5, MCU1.3 (PD1)
/MISO: MCU1.18 (PB4), PiConnector1.21 (MISO0/GPIO9)
/MOSI: MCU1.17 (PB3), PiConnector1.19 (MOSI0/GPIO10)
/NORPU: ProNOR1.3, ProNOR1.4, RProPU1.3 (R2)
/PWMA: GateDriver1.2 (IN), MCU1.5 (PD3)
/PWMA_HO: MosfetS1.1 (G), RGateS1.2, TestS1.1
/PWMA_LO: MosfetS2.1 (G), RGateS2.2, TestS2.1
/PWMB: GateDriver2.2 (IN), MCU1.6 (PD4)
/PWMB_HO: MosfetS3.1 (G), RGateS3.2, TestS3.1
/PWMB_LO: MosfetS4.1 (G), RGateS4.2, TestS4.1
/ProReset: MCU1.15 (PB1), ProNOR1.6, RProPD1.3 (R2), TestProReset1.1
/Red1: MCU1.4 (PD2), ResistorArray1.1 (R1.1)
/Red2: MCU1.11 (PD5), ResistorArray1.5 (R3.1)
/SCLK: MCU1.19 (PB5), PiConnector1.23 (SCLK0/GPIO11)
/VAC: MCU1.25 (PC2)
/VCCPi: JVCC1.3, PiConnector1.2 (5V), PiConnector1.4 (5V)
/VCCSupply: JVCC1.5, Supply5V1.3 (VO)
/VCCTTL: HeaderFTDI1.3, JVCC1.1
/VDC: MCU1.23 (PC0), RVSenBotDC1.1, RVSenTopDC1.2
GND: C1.2, C2.2, COsc1.1, COsc2.2, CSup1.2, Decap1.2, Decap2.2, GateDriver1.4 (COM), GateDriver2.4 (COM), HeaderFTDI1.1, HeaderFTDI1.2, ISenAC1.5 (GND), ISenDC1.5 (GND), LED1.2 (K), LED2.2 (K), MCU1.8 (GND), MCU1.22 (GND), MosfetS2.3 (S), MosfetS4.3 (S), PiConnector1.6 (GND), PiConnector1.9 (GND), PiConnector1.14 (GND), PiConnector1.20 (GND), PiConnector1.25 (GND), PiConnector1.30 (GND), PiConnector1.34 (GND), PiConnector1.39 (GND), ProComp1.4 (V-), ProNOR1.7 (GND), RProPD1.1 (common), RVSenBotDC1.2, Supply5V1.2 (GND), TermDC1.2, TestGND1.1, TestGND1.2, TestGND1.3, TestGND1.4, TestGND2.1, TestGND2.2, TestGND2.3, TestGND3.1, TestGND3.2, TestGND3.3, TestGND3.4
unnamed: CBoot1.1, DBoot1.1 (K), GateDriver1.8 (VB)
unnamed: CBoot2.1, DBoot2.1 (K), GateDriver2.8 (VB)
unnamed: GateDriver1.7 (HO), RGateS1.1
unnamed: GateDriver1.5 (LO), RGateS2.1
unnamed: CBoot1.2, GateDriver1.6 (VS), L1.1, MosfetS1.3 (S), MosfetS2.2 (D), TestPWM+1.1
unnamed: GateDriver2.7 (HO), RGateS3.1
unnamed: GateDriver2.5 (LO), RGateS4.1
unnamed: CBoot2.2, GateDriver2.6 (VS), L2.2, MosfetS3.3 (S), MosfetS4.2 (D), TestPWM-1.1
unnamed: HeaderDC1.1, HeaderDC1.2, HeaderDC1.3, HeaderDC1.4, ISenDC1.1 (IP+), ISenDC1.2 (IP+), Supply5V1.1 (VI), TermDC1.1
unnamed: LED1.1 (A1), ResistorArray1.2 (R1.2)
unnamed: LED1.3 (A2), ResistorArray1.4 (R2.2)
unnamed: LED2.1 (A1), ResistorArray1.6 (R3.2)
unnamed: LED2.3 (A2), ResistorArray1.8 (R4.2)
unnamed: COsc1.2, MCU1.9 (XTAL1/PB6), Xtal16MHz1.2
unnamed: COsc2.1, MCU1.10 (XTAL2/PB7), Xtal16MHz1.1
unnamed 49: ISenDC1.3 (IP-), ISenDC1.4 (IP-), MosfetS1.2 (D), MosfetS3.2 (D), RCompPH1.2, RVSenTopDC1.1; also elsewhere on the board
unnamed: C1.1, ISenAC1.3 (IP-), ISenAC1.4 (IP-), L1.2, TestAC+1.1
VCC: CSup1.1, DBoot1.2 (A), DBoot2.2 (A), Decap1.1, Decap2.1, GateDriver1.1 (VCC), GateDriver2.1 (VCC), ISenAC1.8 (VCC), ISenDC1.8 (VCC), JVCC1.2, JVCC1.4, JVCC1.6, MCU1.7 (VCC), MCU1.20 (AVCC), ProComp1.8 (V+), ProNOR1.14 (VCC), RDTR1.1, RProPU1.1 (common), TestVCC1.1

Notes on the sheet:
RXI
GND
VCC
TX0
DTR
CTS

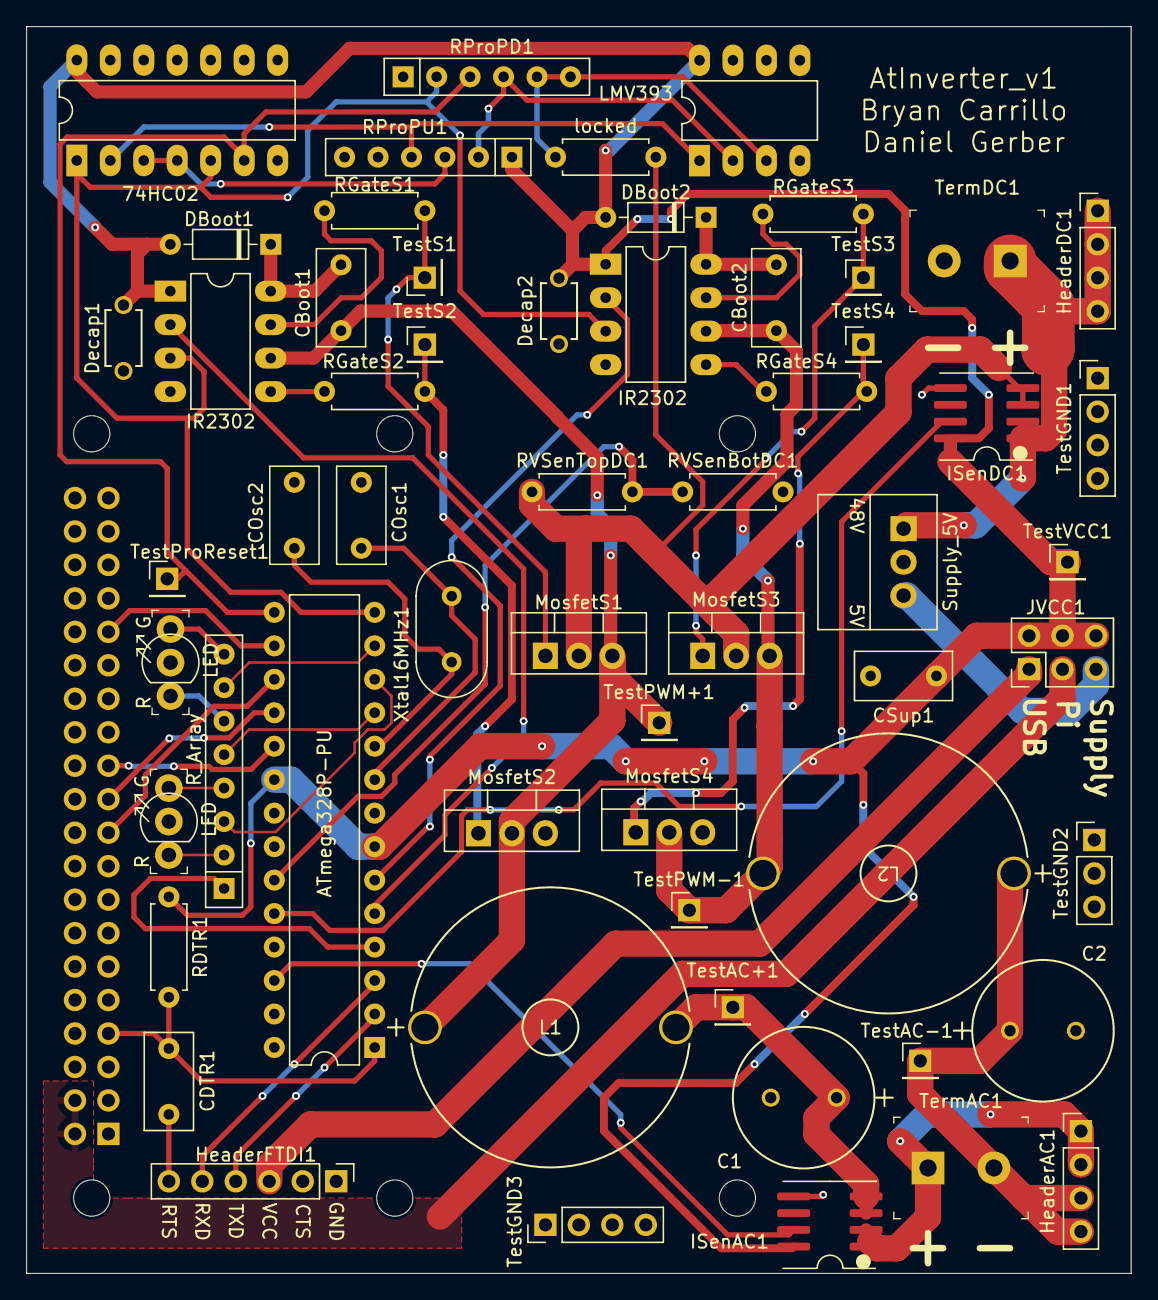
[picture p102: board AtInverter_v1.kicad_pcb from above]

Board: 2 copper layers, 83.8 x 94.6 mm, 60 parts (1 on the bottom side), 51 nets.

Other parts of the board:
locked: 120kΩ; R_Axial_DIN0207_L6.3mm_D2.5mm_P7.62mm_Horizontal

Their connections:
/CompP: locked.1; also elsewhere on the board
unnamed 49: locked.2; also elsewhere on the board
