bcarrillo1051/Atinverter/(commit log)

2024-04-24 AtinverterE KICAD and Programming Directories
    [AtInverter_v1-B_Mask.gbs, AtInverter_v1-B_Paste.gbp, AtInverter_v1-B_Silkscreen.gbo, AtInverter_v1-Back.gbl, AtInverter_v1-Edge_Cuts.gm1, AtInverter_v1-F_Mask.gts, AtInverter_v1-F_Paste.gtp, AtInverter_v1-F_Silkscreen.gto]
2024-04-25 Atinverter V1 BOM
    Build of Materials for the 1st iteration of the DC to AC inverter design for the Microgrid PDA
    [Atinverter V1 BOM.xlsx]
2024-05-16 Created config file to use Cayman theme for GitHub Pages
    [AtInverter_v1.kicad_sch, Atinverter V1 BOM.xlsx]
2024-05-17 remove Atinverter autosave BOM
2024-06-03 commented 50 and 60Hz PWM inverter files, added hardware.html file and added 'Hardware' button that creates hardware documententation page for web page
    [AtInverter_v1.kicad_sch]
2024-10-02 Update pin mapping for Blink.ino
2024-10-17 Changed footprint for IR2302 to SMD
    [AtInverter_v1.kicad_pcb, AtInverter_v1.kicad_sch]
2025-03-24 Restructured file hierarchy for clarity
    [12V_BOOST_CONVERTER.DSN, 12V_Boost_Converter.opj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]
2025-03-25 Editted pin mapping in class, modified blink code, fully functioning
    [AtInverter_v2.kicad_sch]
2025-03-27 modified kicad folder name from KiCad to kicad for consistency of lowercase folders
2025-03-30 Updated Library code with OOP PWM, preliminary Vac code
2025-03-31 Updated Lib code, obtained many captures of device, stopped at readADC dev
2025-04-07 Improved commenting of code, consolidated readAvgVdc() and readAvgIdc() to readAvg(), added timer2 delay code and new timer2 section for website
2025-04-07 Began documenting timer2 delay code
2025-04-09 ZMPT101B lib fix
    [AtInverter_v2.kicad_sch]
2025-04-14 Added dedicated section for hardware description and high level diagrams
    [AtInverter_v2.kicad_pcb, AtInverter_v2.kicad_sch]
2025-04-15 Fixed max current values
2025-04-17 modifications to a_v2 hardware docs section
    [AtInverter_v1-B_Mask.gbs, AtInverter_v1-B_Paste.gbp, AtInverter_v1-B_Silkscreen.gbo, AtInverter_v1-Back.gbl, AtInverter_v1-Edge_Cuts.gm1, AtInverter_v1-F_Mask.gts, AtInverter_v1-F_Paste.gtp, AtInverter_v1-F_Silkscreen.gto]
2025-04-21 Organized simulation files, created template for software lib and modules doc, finalized AC voltage sensor ltspice sim, and further dev to hardware atinverter v2 description
    [12V_BOOST_CONVERTER.DSN, 12V_Boost_Converter.opj]
2025-04-22 Completed software tab and modified block diagram to be more compact and interact for all nodes of current design
2025-04-22 fixed power cycle gate driver function, updated Main
    [Main.ino]
2025-04-24 Fixed missing if statement for ADC channel selection
2025-04-24 Remove SPI.h include since its already included in the Atinverter.h header, also removed sensitivity parameter from Iac_Sensing.ino since aleady in Atinverter.h
2025-04-24 changed Arduino.h to <Arduino.h>
2025-04-29 Blink and DC V/I software documentation complete
    [AtInverter_v2.kicad_sch]
2025-04-30 Organized library file documentation
    [AtInverter_v2.kicad_pcb]
2025-04-30 Coding documentation nearly done, just need to finish PWM_inversion_feature
2025-05-01 Added section for PWM inversion feature
2025-05-02 organized hw documentation into various sections
    [AtInverter_v1-B_Mask.gbs, AtInverter_v1-B_Paste.gbp, AtInverter_v1-B_Silkscreen.gbo, AtInverter_v1-Back.gbl, AtInverter_v1-Edge_Cuts.gm1, AtInverter_v1-F_Mask.gts, AtInverter_v1-F_Paste.gtp, AtInverter_v1-F_Silkscreen.gto]
2025-05-02 Removed all Serial communication to eliminate power cycle bug
    [Main.ino]
2025-05-02 Reduced redudancy of startPWM method, no need to specify PWM flag
2025-05-03 Altered the PWM function calls
2025-05-07 Completed Overvoltage and Reset Protection Hardware Section
    [AtInverter_v2.kicad_pcb, AtInverter_v2.kicad_sch]
2025-05-13 Removed constructor frequency parameter and delegated the PWM inversion fundamental frequency setting to startPWM(), documentation also updated accordingly
2025-05-14 Added a macro to describe pwm sinusoid arrays for readability
2025-05-19 Completed and verified AC current sensing code
2025-05-26 Eliminated PWM on startup
